lsd-maddrive/zaWRka-project/controller_wr_driver/README.md

# Драйвер для контроллера zaWRka

## Подготовка

- Set environment `CHIBIOS_ROOT` as path to ChibiOS version 17 directory.

Like this:

```bash
export CHIBIOS_ROOT=$HOME/ChibiStudio/chibios176
```

- Don`t forget to send ssh-key to zaWRka

Полезные ссылки:
* [F767ZI Reference manual (RM)](http://www.st.com/content/ccc/resource/technical/document/reference_manual/group0/96/8b/0d/ec/16/22/43/71/DM00224583/files/DM00224583.pdf/jcr:content/translations/en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)
* [F767ZI Datasheet (DS)](http://www.st.com/content/ccc/resource/technical/document/datasheet/group3/c5/37/9c/1d/a6/09/4e/1a/DM00273119/files/DM00273119.pdf/jcr:content/translations/en.DM0027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)
* [F767ZI Nucleo pinout](https://os.mbed.com/platforms/ST-Nucleo-F767ZI/)
---
* [F767ZI Alternate functions](http://www.st.com/content/ccc/resource/technical/document/datasheet/group3/c5/37/9c/1d/a6/09/4e/1a/DM00273119/files/DM00273119.pdf/jcr:content/translations/en.DM0027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)
* [F767ZI Pins assignment (+analogs)](http://www.st.com/content/ccc/resource/technical/document/datasheet/group3/c5/37/9c/1d/a6/09/4e/1a/DM00273119/files/DM00273119.pdf/jcr:content/translations/en.DM0027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)
* [F767ZI Timer triggers](http://www.st.com/content/ccc/resource/technical/document/reference_manual/group0/96/8b/0d/ec/16/22/43/71/DM00224583/files/DM00224583.pdf/jcr:content/translations/en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)
