lsd-maddrive/zaWRka-project/docs/presentations/Autonet2020.pptx

## Autonet 2020

Девяткин Алексей

## Задача этого года

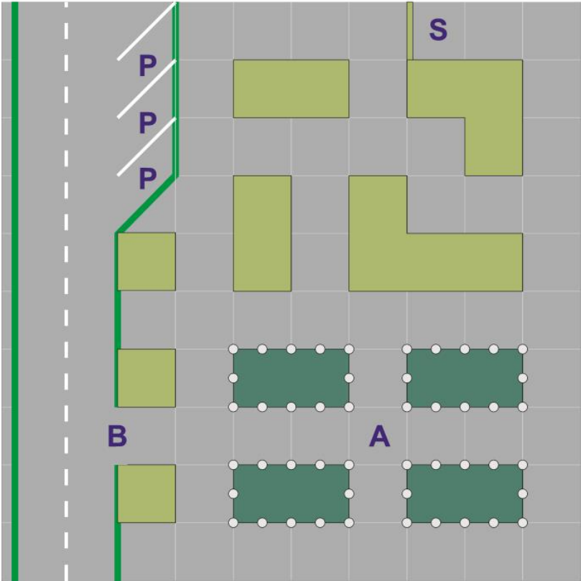
[picture p5: figure]

Ссылка: http://russianrobotics.ru/competition/autonet/autonet-18/
- Выехать из города
- Проехать по скоростному участку
- Припарковаться на свободном месте

## Этап 1 - Движение в городе

- Движение по знакам
- Остановка перед белой линией светофора (красный)
- Нет препятствий

## Этап 2 - Движение по скоростному участку

- Могут быть препятствия в виде грузовиков
- Препятствие не более 50 см по стороне

## Этап 3 - Парковка

- Припарковаться в одном из трех мест
- Место может быть занято

## Этап 1 - Решение

Базовая логика

Конечный автомат

Детектор знаков

Детектор белой линии

Решатель лабиринта

ROS планер

## Этап 1 - Решение

- Дождаться информации с контроллера о том, что кнопка нажата (ROS топик)
- Решить лабиринт с учетом расположения (решатель)
- Передать точки движения из решателя и задать цель (выезд из лабиринта) планеру
- Если встретилась линия и красный светофор - сбросить цель, дождаться зеленого, снова задать цель
- Если знак возле развилки - задать ограничения решателю на целевой узел, получить новые точки от решателя и передать планеру
- Если доехали -> второй этап

## Этап 1 - Решение (конечный автомат)

- IDLE - ждем кнопку
- MOVE_TARGET - движемся к цели (читаем линию знаки)
- WAIT_TL - ждем зеленого света (читаем знаки)
- WAIT_SIGNS (???) - без движения проверяем знаки (читаем знаки)
- TARGET_REACHED - достигли цели (следующий этап)
- MOVE_SPEED - движение по скоростному участку (ждем достижения цели)
- SPEED_REACHED - закончили скоростной участок
- ANALYZING_PARKING - анализ парковки
- MOVE_PARKING - паркуемся (ждем достижения цели)
- PARKING_REACHED - закончили парковку

## Этап 2 - Решение

- Просто проехать по планеру =)
- Обновляем конфигурацию планера -> выше скорость

## Этап 3 - Решение

- Разрабатывается решение по анализу заранее заданного места для парковки
- Обновляем конфигурацию планера -> ниже скорость

## Спасибо за внимание!
