lsd-maddrive/zaWRka-project/3D_models/jetson_case/Nvidia_Jetson_Nano_Case__NanoMesh_Desktop/images/6d35b3677f04a7914d906e52e0687398_preview_featured.JPG

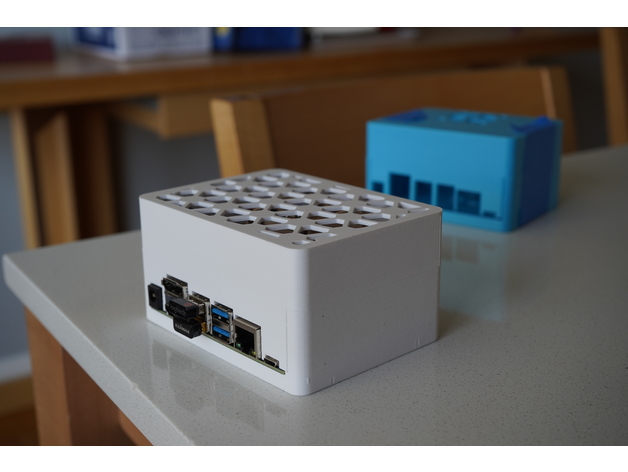
3D_models/jetson_case/Nvidia_Jetson_Nano_Case__NanoMesh_Desktop/images/6d35b3677f04a7914d906e52e0687398_preview_featured.JPG
