lsd-maddrive/zaWRka-project/3D_models/jetson_case/Nvidia_Jetson_Nano_Case__NanoMesh_Desktop/images/019526b72700fd8e877444ab914aaee8_preview_featured.JPG

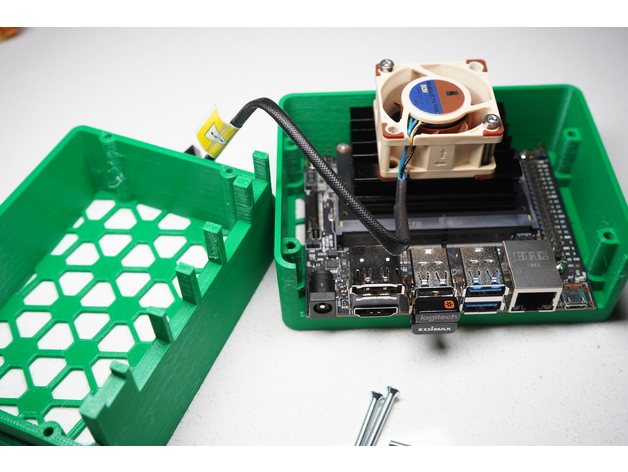
3D_models/jetson_case/Nvidia_Jetson_Nano_Case__NanoMesh_Desktop/images/019526b72700fd8e877444ab914aaee8_preview_featured.JPG
