lsd-maddrive/zaWRka-project/3D_models/jetson_case/Nvidia_Jetson_Nano_Case__NanoMesh_Desktop/images/a8ec58c3724dc3419c5b495eca3d6831_preview_featured.JPG

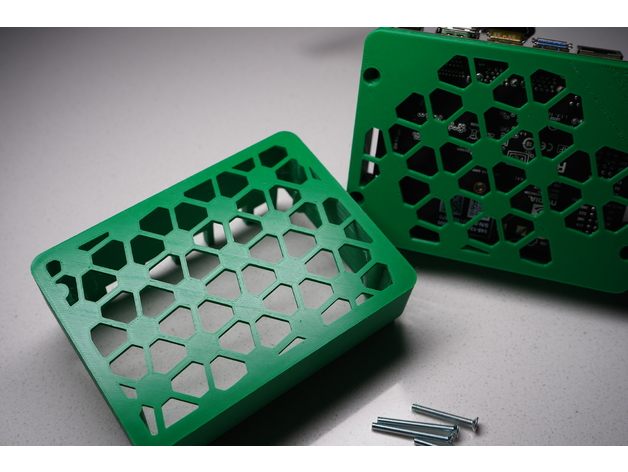
3D_models/jetson_case/Nvidia_Jetson_Nano_Case__NanoMesh_Desktop/images/a8ec58c3724dc3419c5b495eca3d6831_preview_featured.JPG
