lsd-maddrive/zaWRka-project/3D_models/jetson_case/Nvidia_Jetson_Nano_Case__NanoMesh_Desktop/images/aa94fbc3bea92b1af5b5fca5223404d8_preview_featured.jpg

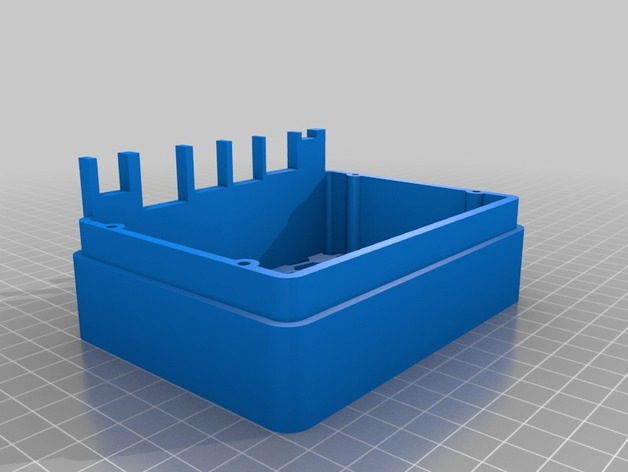
3D_models/jetson_case/Nvidia_Jetson_Nano_Case__NanoMesh_Desktop/images/aa94fbc3bea92b1af5b5fca5223404d8_preview_featured.jpg
