lsd-maddrive/zaWRka-project/3D_models/jetson_case/Nvidia_Jetson_Nano_Case__NanoMesh_Desktop/images/d14ae87a6a375f4f10650ded05f34fa1_preview_featured.jpg

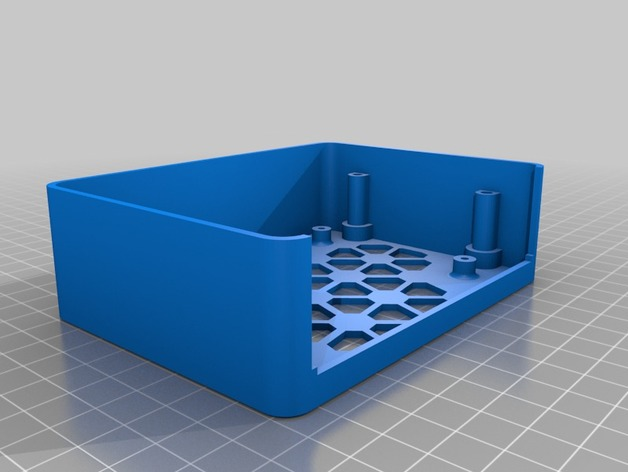
3D_models/jetson_case/Nvidia_Jetson_Nano_Case__NanoMesh_Desktop/images/d14ae87a6a375f4f10650ded05f34fa1_preview_featured.jpg
