lsd-maddrive/zaWRka-project/3D_models/jetson_case/Nvidia_Jetson_Nano_Case__NanoMesh_Desktop/images/f1ab23783ada1df2c52e6c94efddc131_preview_featured.JPG

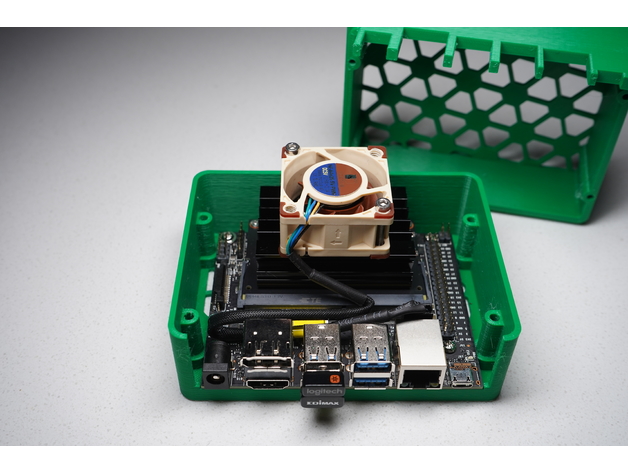
3D_models/jetson_case/Nvidia_Jetson_Nano_Case__NanoMesh_Desktop/images/f1ab23783ada1df2c52e6c94efddc131_preview_featured.JPG
