lsd-maddrive/zaWRka-project/3D_models/jetson_case/Nvidia_Jetson_Nano_Case__NanoMesh_Desktop/images/f44073ed6252e81bb559d2e7bacd4eea_preview_featured.JPG

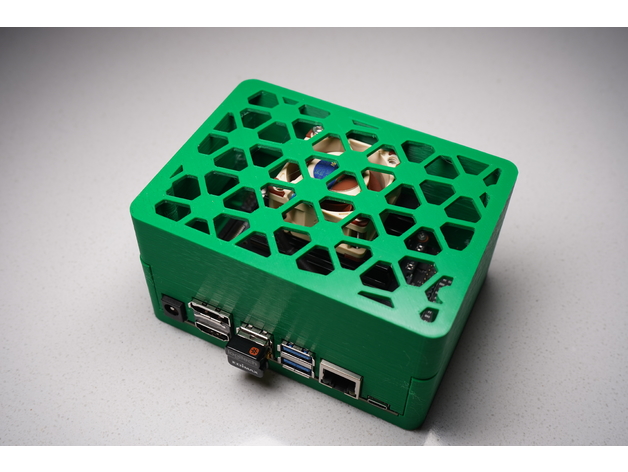
3D_models/jetson_case/Nvidia_Jetson_Nano_Case__NanoMesh_Desktop/images/f44073ed6252e81bb559d2e7bacd4eea_preview_featured.JPG
