lsd-maddrive/zaWRka-project/Altium_projects/zaWRka_Project/car1.bmp

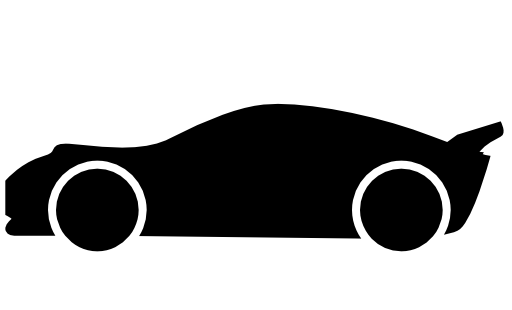
Altium_projects/zaWRka_Project/car1.bmp
