lsd-maddrive/zaWRka-project/docs/rendered/zaWRka-uC.png

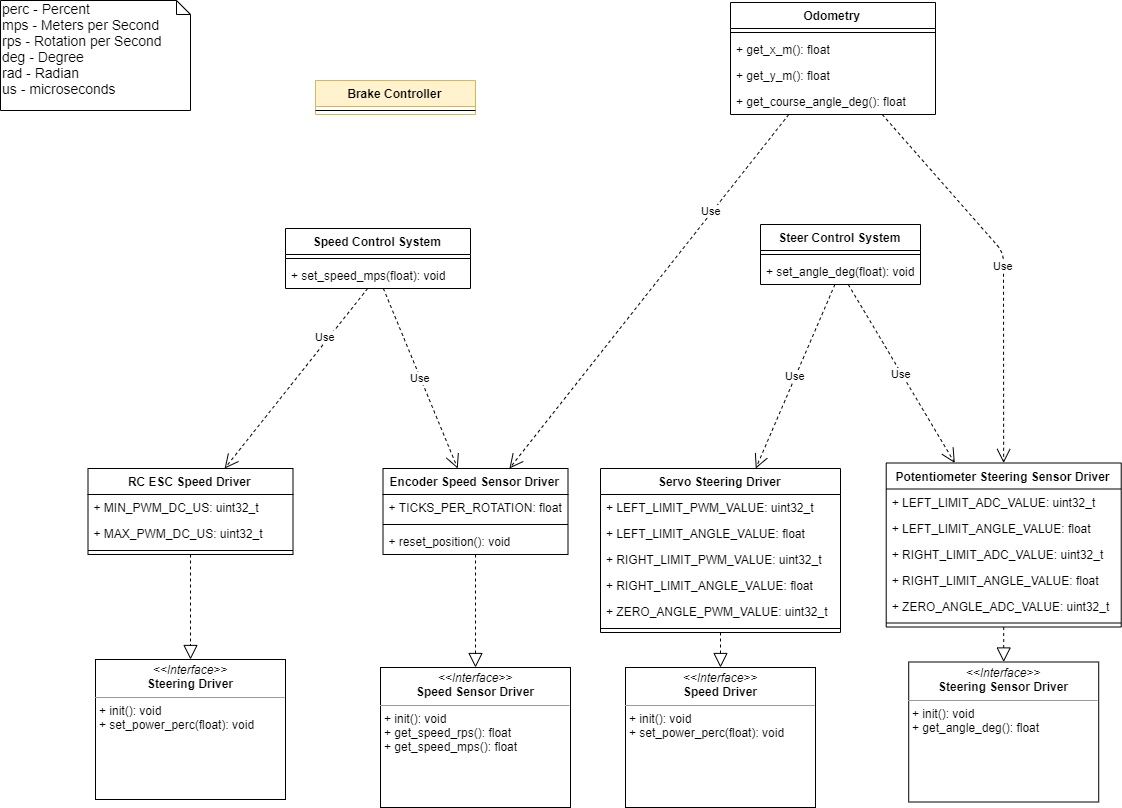
docs/rendered/zaWRka-uC.png
