lsd-maddrive/zaWRka-project/wr8_software/scripts/graph_path/signs.jpg

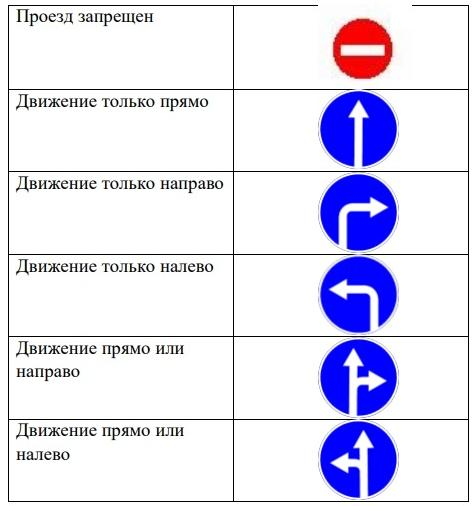
wr8_software/scripts/graph_path/signs.jpg
