lsd-maddrive/zaWRka-project/3D_models/2s_accum_holder/Battery_holder.FCStd

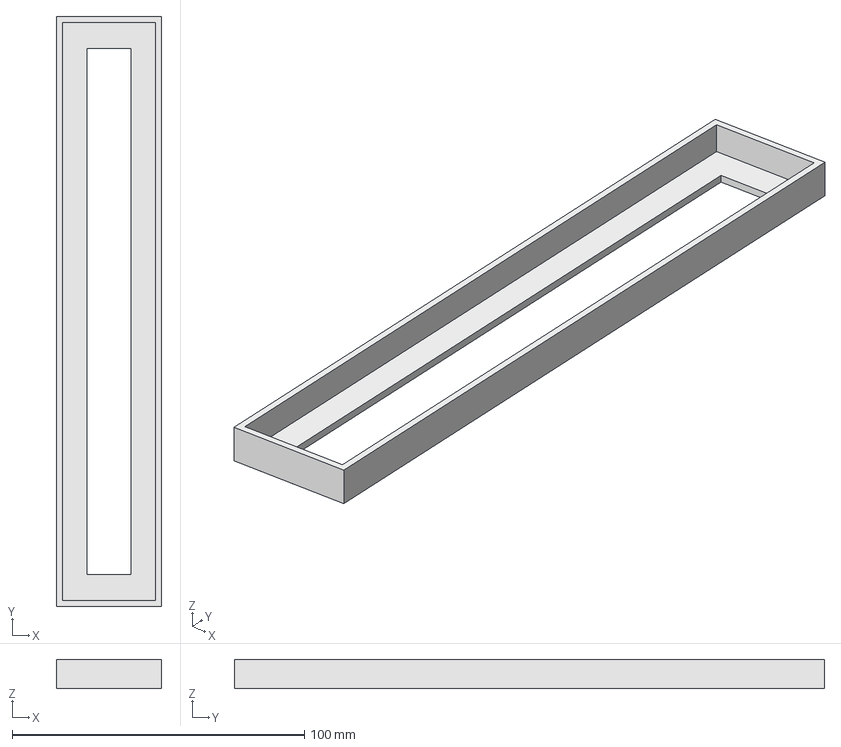
[picture p54: CAD file, 2020-01-11]
3D_models/2s_accum_holder/Battery_holder.FCStd
36.0 x 202.0 x 10.0 mm
