lsd-maddrive/zaWRka-project/3D_models/Battery_charge_check/Battery_up_1.stl

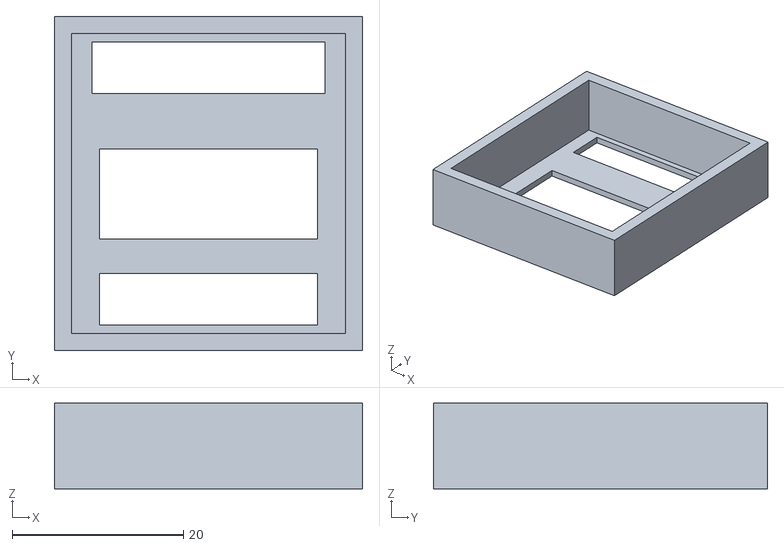
[picture p55: CAD file, 2020-01-11]
3D_models/Battery_charge_check/Battery_up_1.stl
36.0 x 39.0 x 10.0
