lsd-maddrive/zaWRka-project/3D_models/battery_holder/wr8_frame.stl

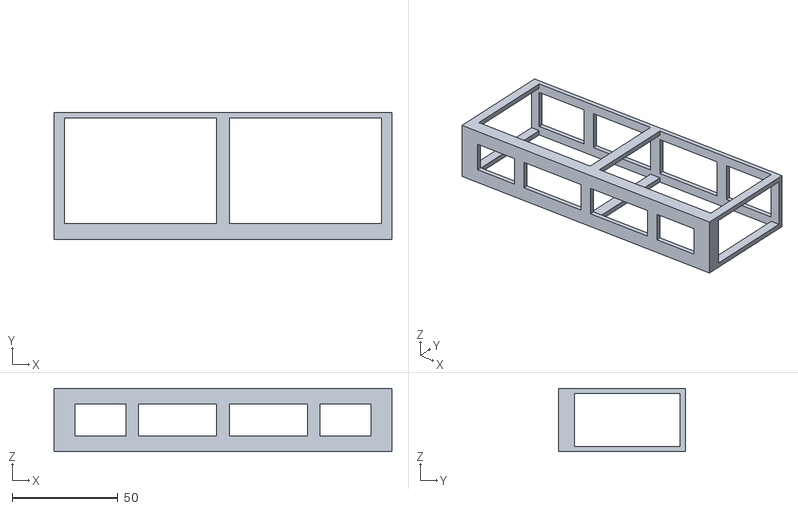
[picture p56: CAD file, 2020-03-07]
3D_models/battery_holder/wr8_frame.stl
160.0 x 60.0 x 30.0
