lsd-maddrive/zaWRka-project/3D_models/Encoder_new/Motor_hold.FCStd

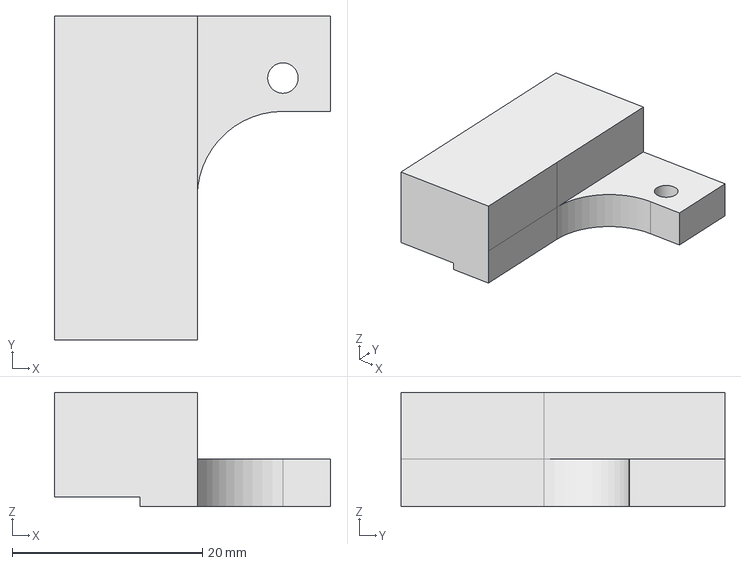
[picture p57: CAD file, 2020-01-11]
3D_models/Encoder_new/Motor_hold.FCStd
29.0 x 34.0 x 12.0 mm
