lsd-maddrive/zaWRka-project/3D_models/jetson_case/Nvidia_Jetson_Nano_Case__NanoMesh_Desktop/files/NanoMeshDesktop-Top-Jetson-Nano-DevKit-Case.stl

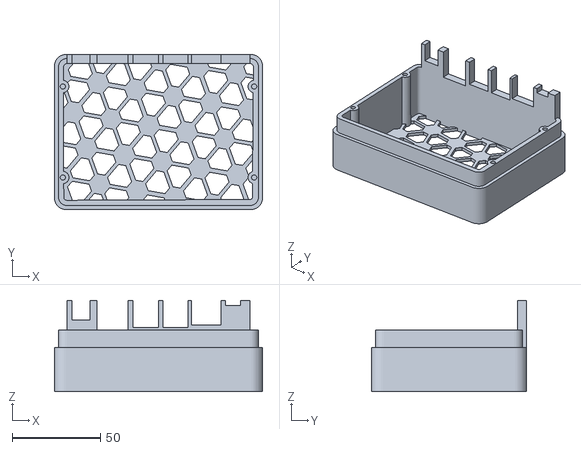
[picture p58: CAD file, 2020-01-11]
3D_models/jetson_case/Nvidia_Jetson_Nano_Case__NanoMesh_Desktop/files/NanoMeshDesktop-Top-Jetson-Nano-DevKit-Case.stl
118.0 x 88.0 x 51.8
