lsd-maddrive/zaWRka-project/3D_models/jetson_case/top.FCStd

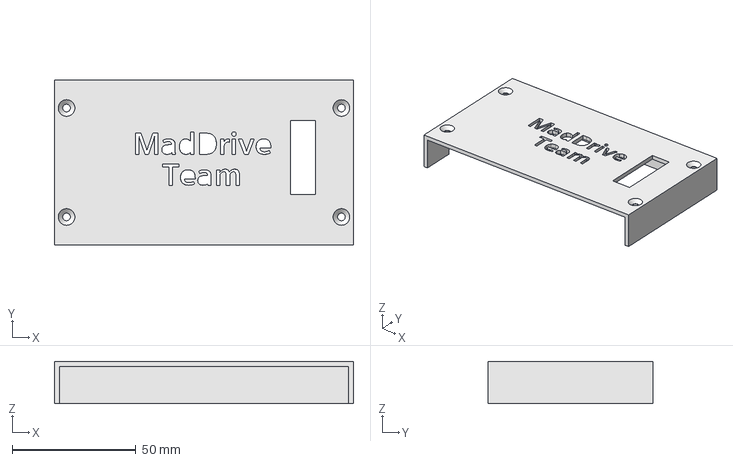
[picture p59: CAD file, 2020-01-11]
3D_models/jetson_case/top.FCStd
120.8 x 66.8 x 17.0 mm
