lsd-maddrive/zaWRka-project/3D_models/Lev_0_button_holder/Button_holder_2.stl

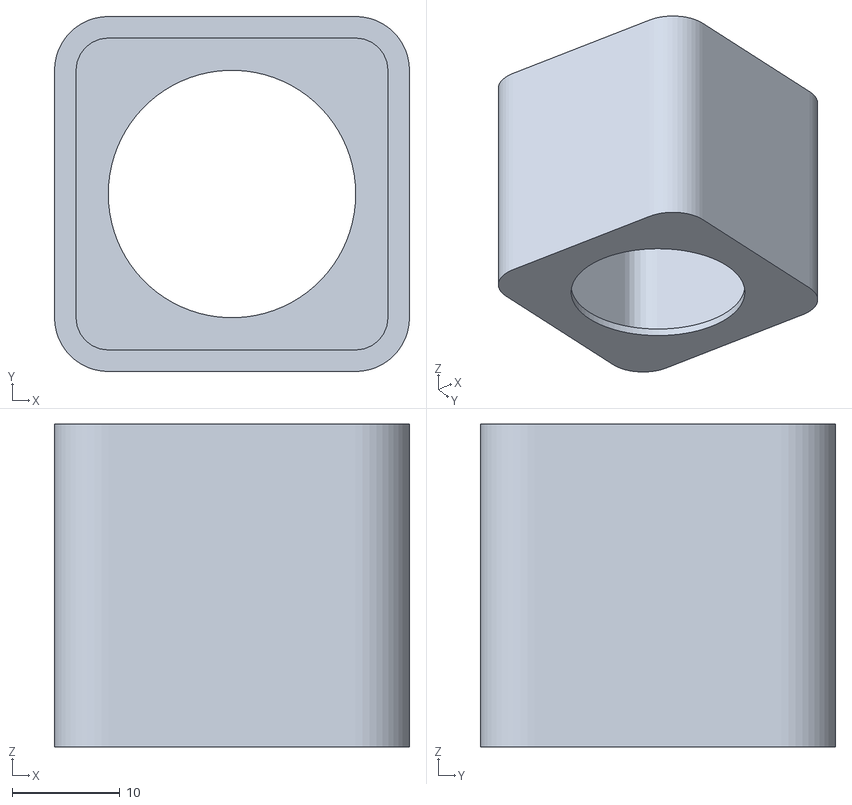
[picture p60: CAD file, 2020-01-11]
3D_models/Lev_0_button_holder/Button_holder_2.stl
33.0 x 33.0 x 30.0
