lsd-maddrive/zaWRka-project/3D_models/Lev_0_ESC_holder/ESC_holder_tight.FCStd

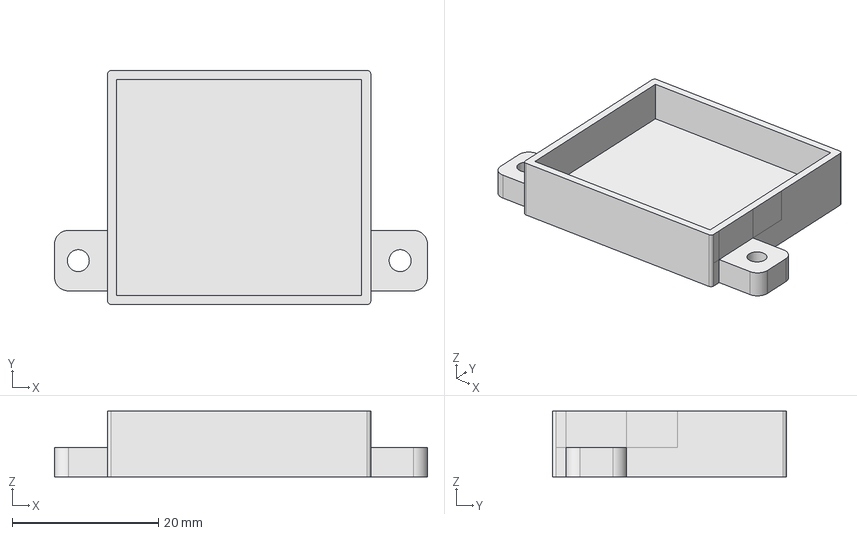
[picture p61: CAD file, 2020-01-11]
3D_models/Lev_0_ESC_holder/ESC_holder_tight.FCStd
51.0 x 32.0 x 9.00 mm
