lsd-maddrive/zaWRka-project/3D_models/Lidar_board/bottom.FCStd

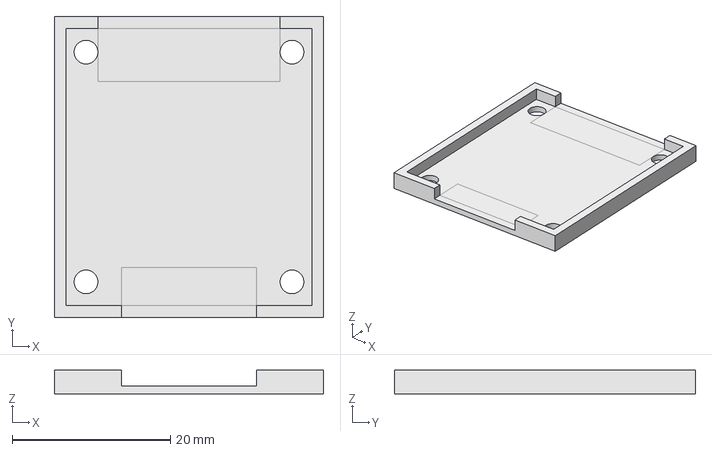
[picture p62: CAD file, 2020-01-11]
3D_models/Lidar_board/bottom.FCStd
34.0 x 38.0 x 3.00 mm
