lsd-maddrive/zaWRka-project/3D_models/name.FCStd

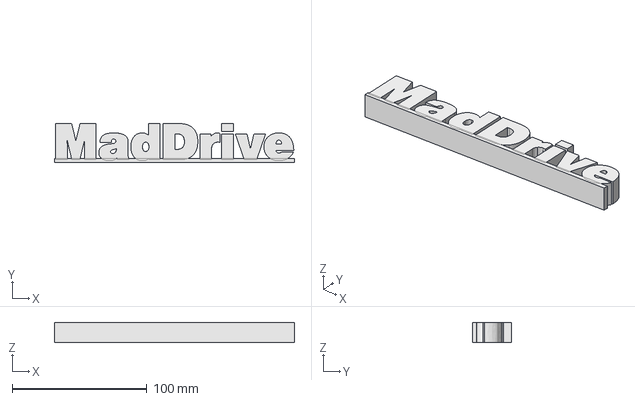
[picture p63: CAD file, 2020-01-11]
3D_models/name.FCStd
178.0 x 28.8 x 15.0 mm
