lsd-maddrive/zaWRka-project/3D_models/power_conv/box/box_power.FCStd

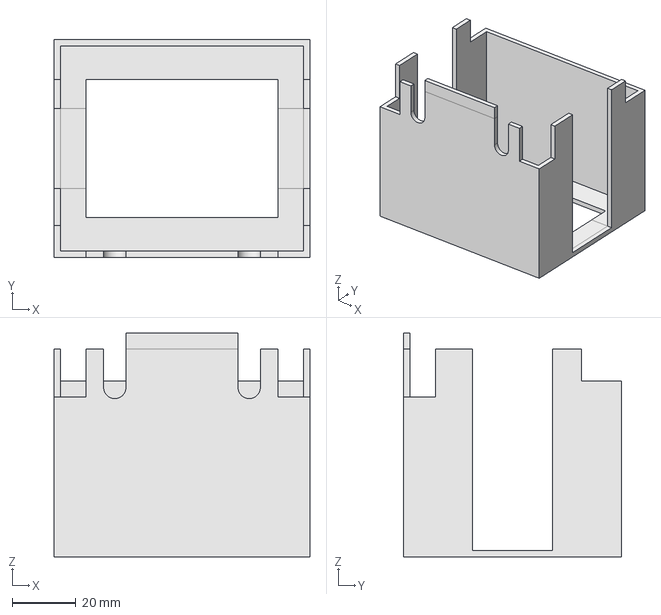
[picture p64: CAD file, 2020-03-07]
3D_models/power_conv/box/box_power.FCStd
80.0 x 68.0 x 70.0 mm
