lsd-maddrive/zaWRka-project/3D_models/power_conv/tree_lev_0.stl

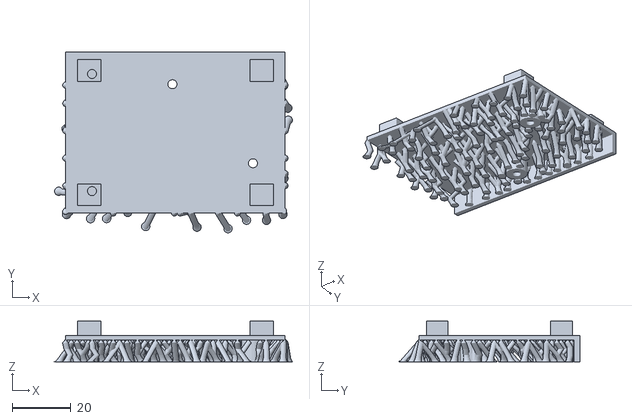
[picture p65: CAD file, 2020-01-11]
3D_models/power_conv/tree_lev_0.stl
81.3 x 61.8 x 14.0
