lsd-maddrive/zaWRka-project/3D_models/Power_new/power_wire.FCStd

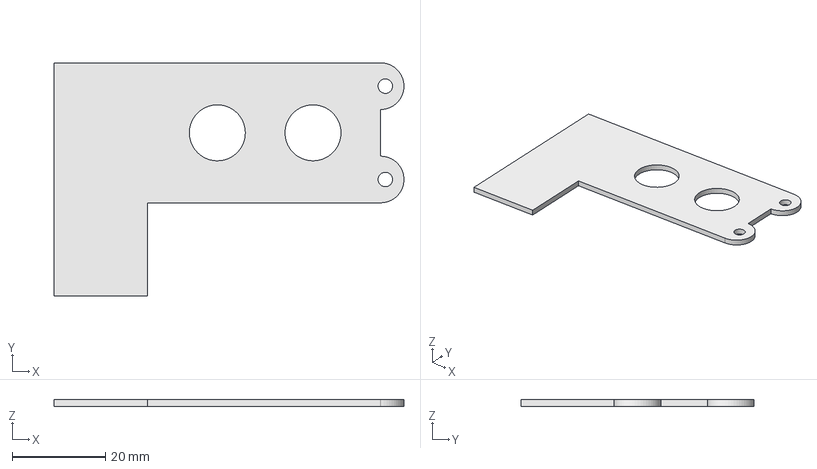
[picture p66: CAD file, 2020-01-11]
3D_models/Power_new/power_wire.FCStd
75.0 x 50.0 x 1.50 mm
