lsd-maddrive/zaWRka-project/3D_models/servo_kach/servo1.stl

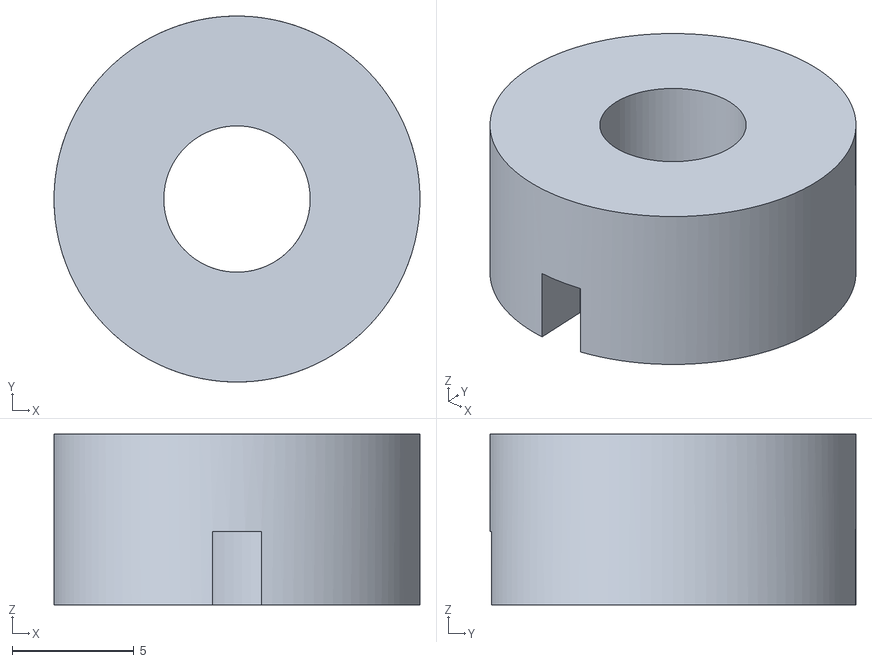
[picture p67: CAD file, 2020-01-11]
3D_models/servo_kach/servo1.stl
15.0 x 15.0 x 7.00
