lsd-maddrive/zaWRka-project/3D_models/Spring_support/Spring_support.FCStd

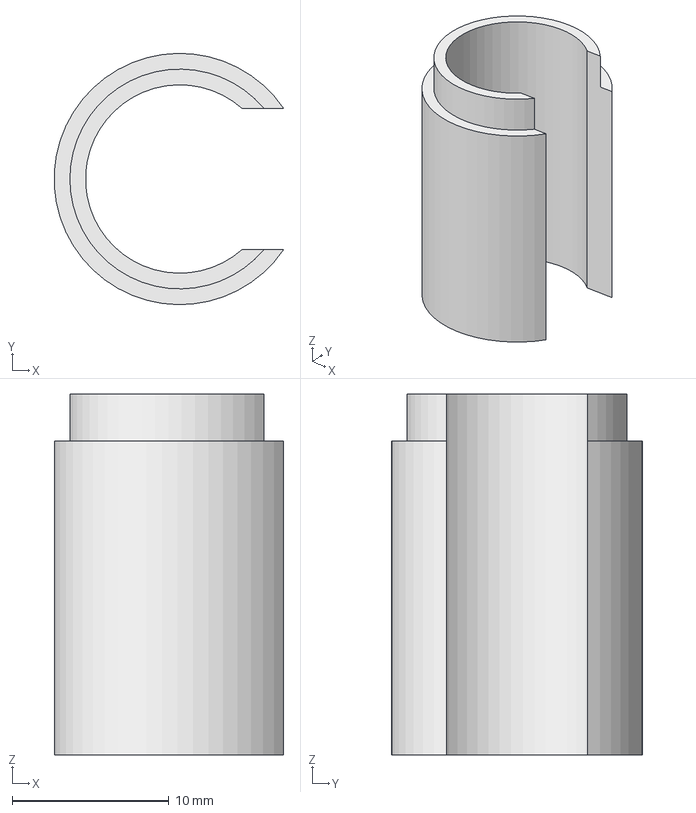
[picture p68: CAD file, 2020-01-11]
3D_models/Spring_support/Spring_support.FCStd
14.6 x 16.0 x 23.0 mm
