lsd-maddrive/zaWRka-project/3D_models/STM_hold_corner/STM_holder_rev.FCStd

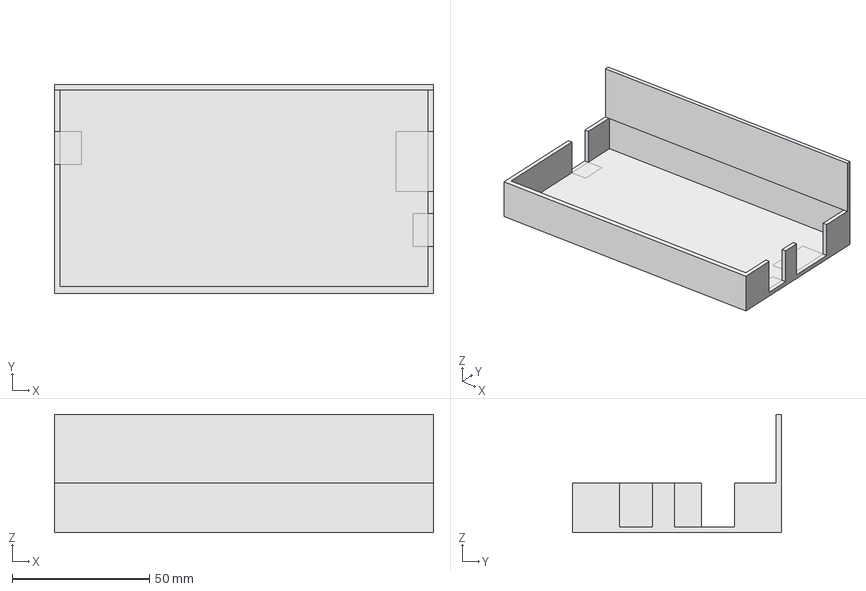
[picture p69: CAD file, 2020-03-07]
3D_models/STM_hold_corner/STM_holder_rev.FCStd
138.0 x 76.0 x 43.0 mm
