lsd-maddrive/zaWRka-project/3D_models/Transmitter_holder/Transmitter_holder.FCStd

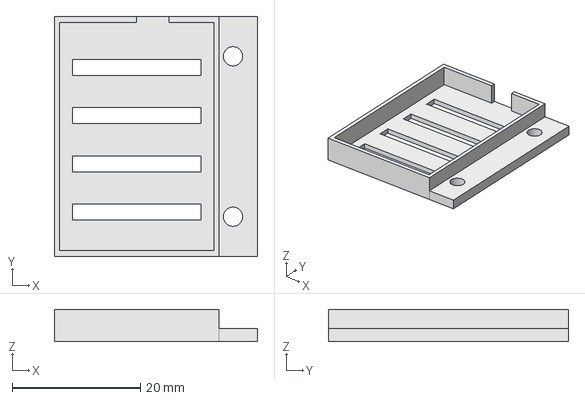
[picture p70: CAD file, 2020-01-11]
3D_models/Transmitter_holder/Transmitter_holder.FCStd
31.7 x 37.4 x 5.00 mm
