lsd-maddrive/zaWRka-project/3D_models/Turn/tirn_v1.FCStd

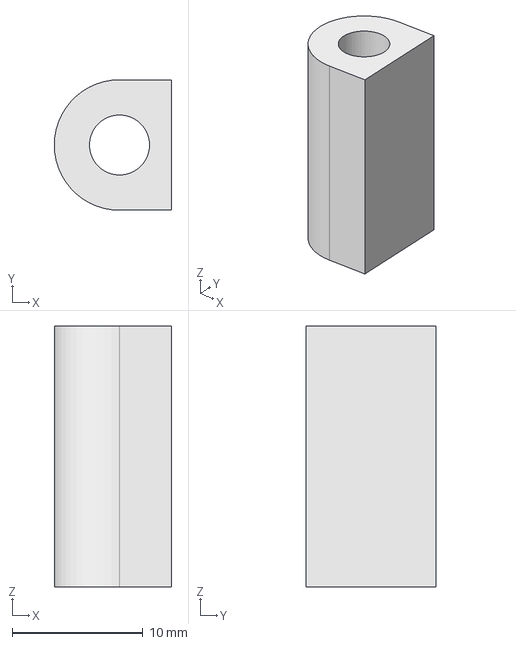
[picture p71: CAD file, 2020-01-11]
3D_models/Turn/tirn_v1.FCStd
9.00 x 10.0 x 20.0 mm
