lsd-maddrive/zaWRka-project/3D_models/jetson_case/bottom.FCStd

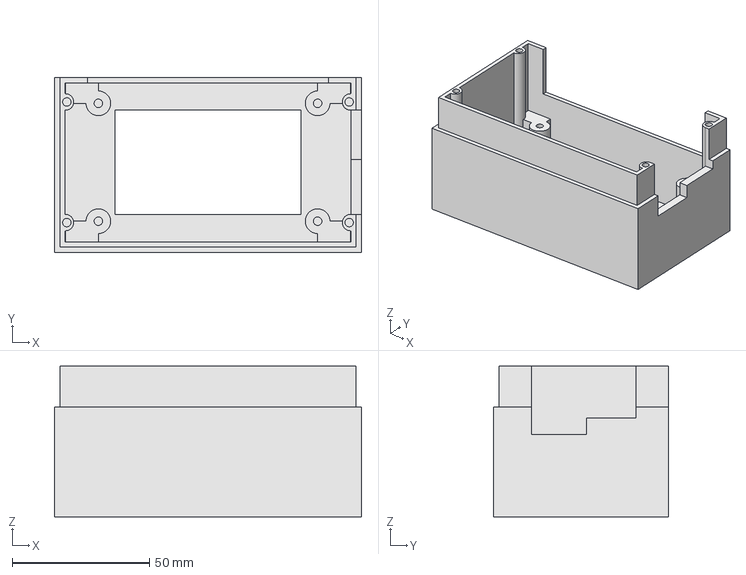
[picture p72: CAD file, 2020-01-11]
3D_models/jetson_case/bottom.FCStd
112.0 x 64.0 x 55.0 mm
