lsd-maddrive/zaWRka-project/3D_models/Lidar_board/top.FCStd

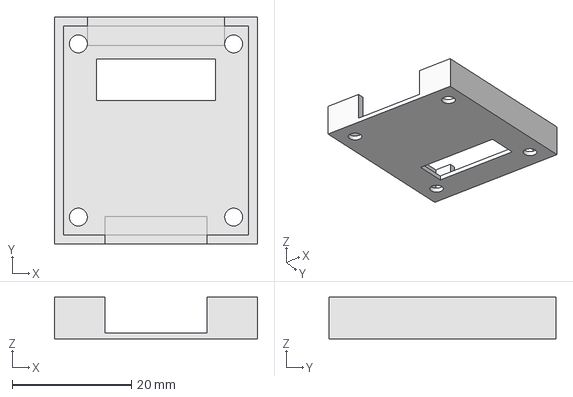
[picture p74: CAD file, 2020-01-11]
3D_models/Lidar_board/top.FCStd
34.0 x 38.0 x 7.00 mm
