lsd-maddrive/zaWRka-project/3D_models/power_conv/tree_lev_1.stl

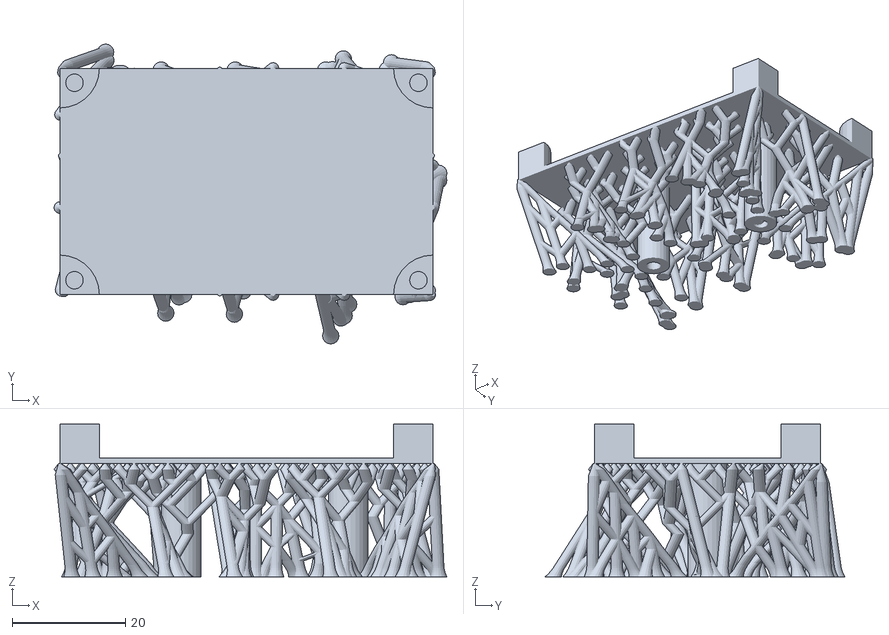
[picture p75: CAD file, 2020-01-11]
3D_models/power_conv/tree_lev_1.stl
69.5 x 53.0 x 27.0
