lsd-maddrive/zaWRka-project/3D_models/Power_new/Power_hold.FCStd

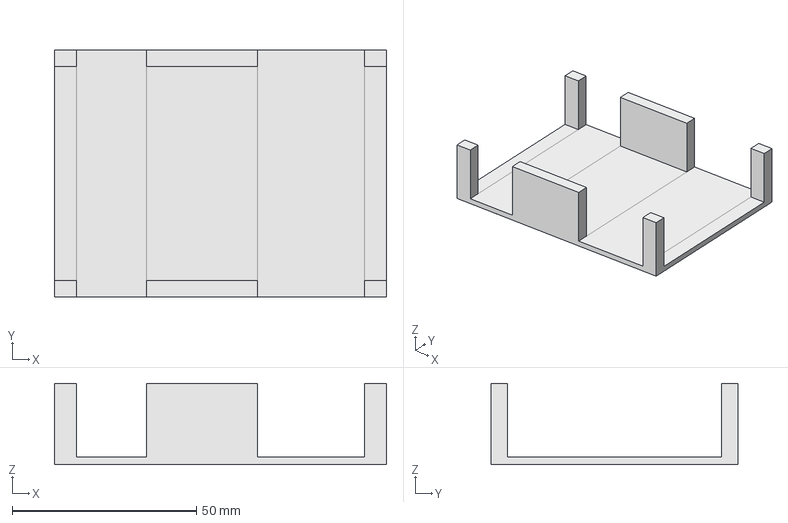
[picture p76: CAD file, 2020-01-11]
3D_models/Power_new/Power_hold.FCStd
90.0 x 67.0 x 22.0 mm
