lsd-maddrive/zaWRka-project/3D_models/servo_kach/servo_kulak.FCStd

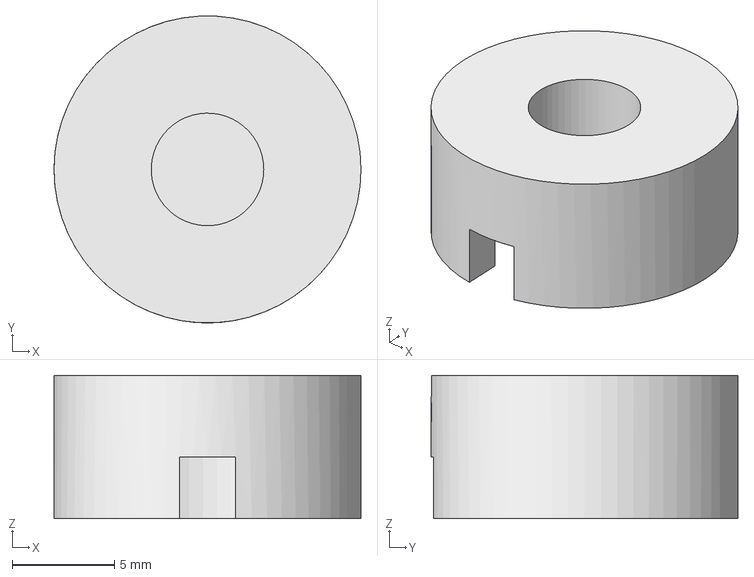
[picture p77: CAD file, 2020-01-11]
3D_models/servo_kach/servo_kulak.FCStd
15.0 x 15.0 x 7.00 mm
