lsd-maddrive/zaWRka-project/3D_models/STM_hold_corner/STM_holder.FCStd

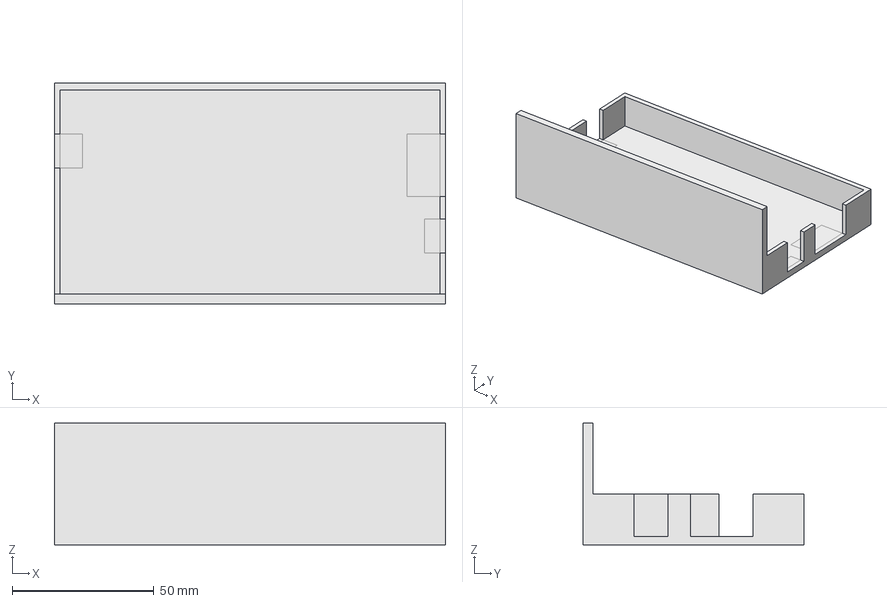
[picture p78: CAD file, 2020-01-11]
3D_models/STM_hold_corner/STM_holder.FCStd
138.0 x 78.0 x 43.0 mm
