lsd-maddrive/zaWRka-project/3D_models/power_conv/level1.FCStd

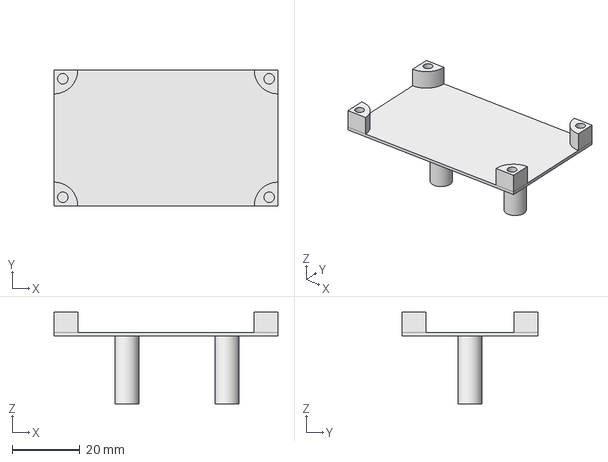
[picture p79: CAD file, 2020-01-11]
3D_models/power_conv/level1.FCStd
66.0 x 40.0 x 27.0 mm
