lsd-maddrive/zaWRka-project/3D_models/power_conv/level2.FCStd

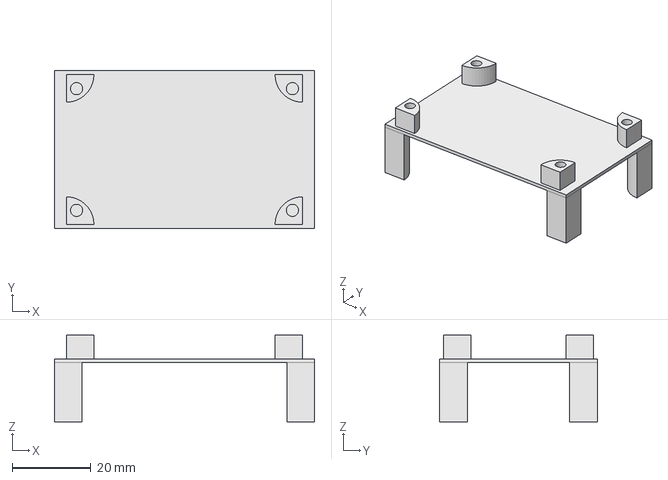
[picture p80: CAD file, 2020-01-11]
3D_models/power_conv/level2.FCStd
66.0 x 40.0 x 22.0 mm
