lsd-maddrive/zaWRka-project/3D_models/STM_hold_corner/stm_corner.FCStd

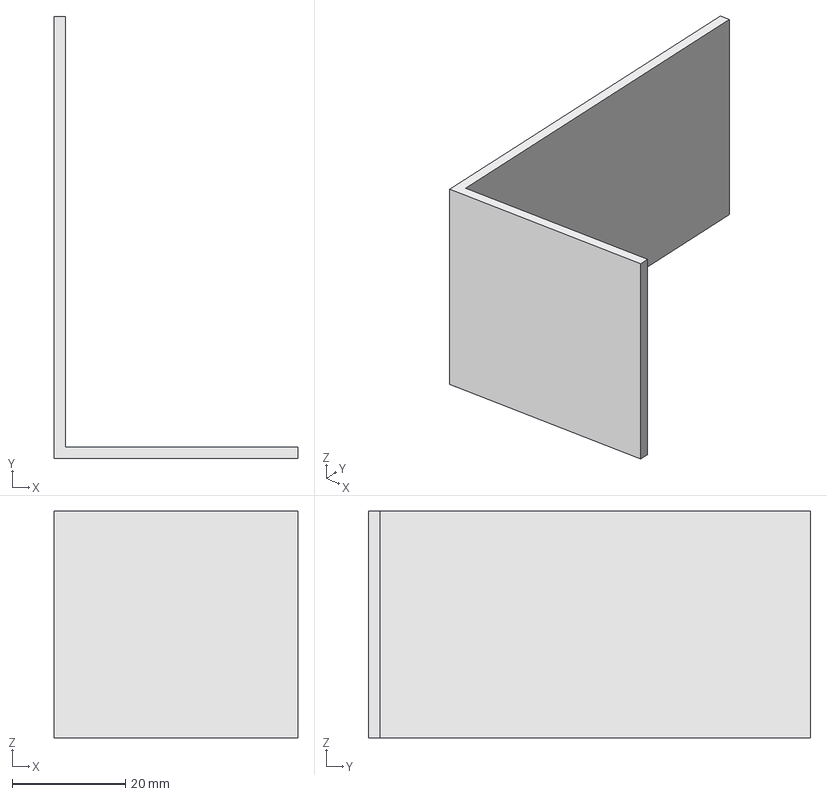
[picture p81: CAD file, 2020-01-11]
3D_models/STM_hold_corner/stm_corner.FCStd
43.0 x 78.0 x 40.0 mm
