lsd-maddrive/zaWRka-project/3D_models/power_conv/tree_lev_2.stl

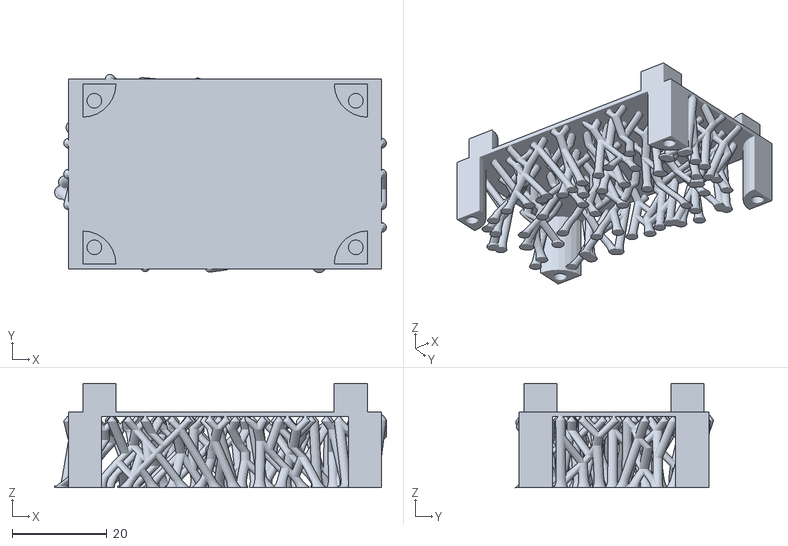
[picture p82: CAD file, 2020-01-11]
3D_models/power_conv/tree_lev_2.stl
70.0 x 41.8 x 22.0
