lsd-maddrive/zaWRka-project/3D_models/power_conv/level0.FCStd

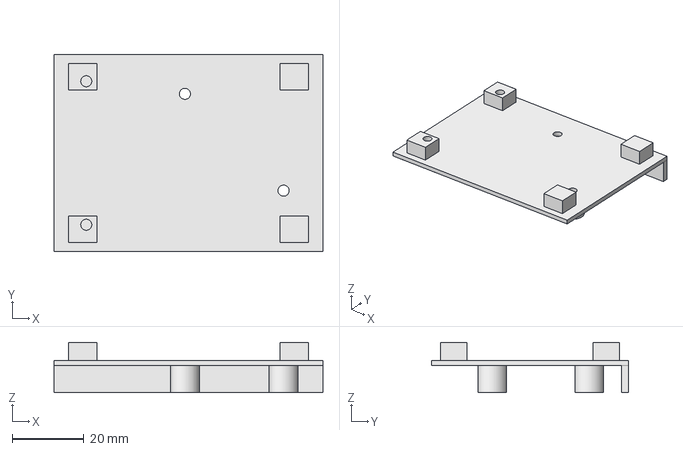
[picture p83: CAD file, 2020-01-11]
3D_models/power_conv/level0.FCStd
75.0 x 55.0 x 14.0 mm
