lsd-maddrive/zaWRka-project/(list of files, cad)

Other CAD files:
3D_models/Battery_charge_check/battery_top.FCStd
3D_models/battery_holder/frame.FCStd
3D_models/Lev_0_button_holder/Button_holder_v2.FCStd
3D_models/Turn/turn.stl
3D_models/Power_new/Power_wr8_hold.stl
3D_models/STM_hold_corner/STM_hold.stl
3D_models/2s_accum_holder/Battery_holder.stl
3D_models/Encoder_new/Motor_hold.stl
3D_models/Lev_0_ESC_holder/ESC_holder_tight.stl
3D_models/Lidar_board/bottom.stl
3D_models/Lidar_board/top.stl
3D_models/Power_new/power_wire.stl
3D_models/STM_hold_corner/STM_holder_rev.stl
3D_models/STM_hold_corner/stm_corner.stl
3D_models/Spring_support/spring_support.stl
3D_models/Transmitter_holder/Transmitter_holder.stl
3D_models/jetson_case/bottom.stl
3D_models/jetson_case/top.stl
3D_models/name.stl
3D_models/power_conv/box/box_power.stl
3D_models/power_conv/level_0.stl
3D_models/power_conv/level_1.stl
3D_models/power_conv/level_2.stl
3D_models/servo_kach/servo_kulak.stl
