lsd-maddrive/zaWRka-project/wr8_software/scripts/line_detector_test_1.png

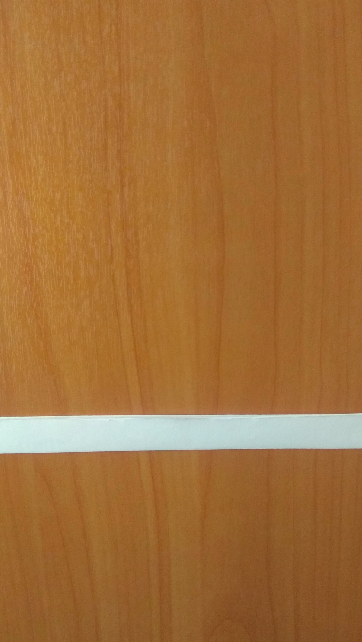
wr8_software/scripts/line_detector_test_1.png
