lsd-maddrive/zaWRka-project/wr8_software/scripts/line_detector_test_2.png

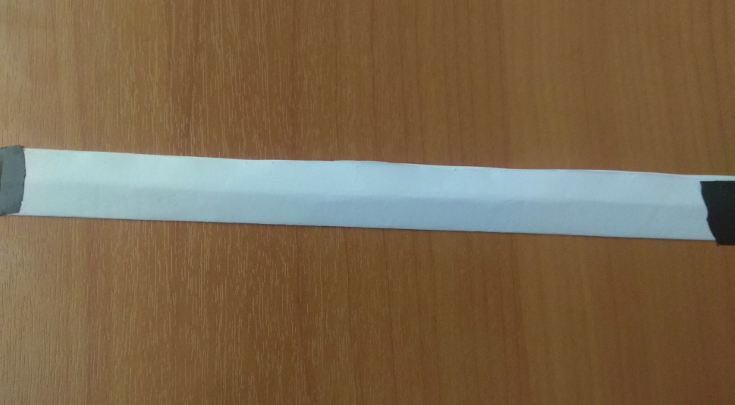
wr8_software/scripts/line_detector_test_2.png
