lsd-maddrive/zaWRka-project/wr8_software/scripts/debug/lane_debug.png

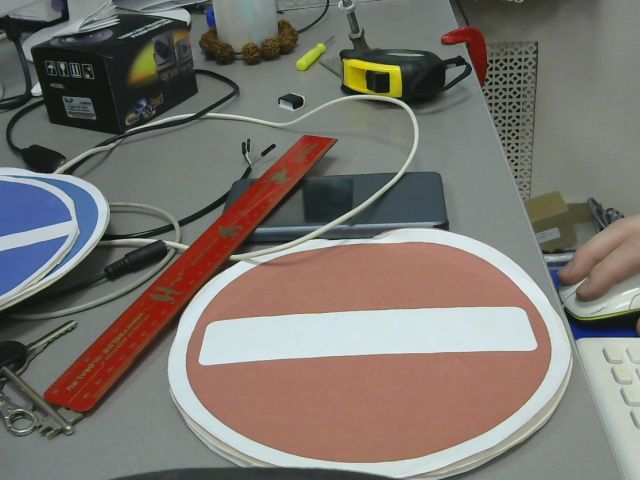
wr8_software/scripts/debug/lane_debug.png
