lsd-maddrive/zaWRka-project/(threads)

Thread 1 (2019-02-11):

Что нужно в ветке master хранить?

serykhelena, 2019-02-11:

KaiL4eK, 2019-02-12:
Пускай мастер будет основной веткой, просто льем туда, когда фича / модуль готовы

KaiL4eK, 2019-02-12:
Либо можно master удалить, а develop сделать основной)

KaiL4eK, 2019-02-12:
Так как вся работа пошла в develop, то предлагаю мастера сносить =)

serykhelena, 2019-02-12:
Сделано (=

Closed 2019-02-12.

Thread 2 (2019-02-12):

Проблема в понимании блока одометрии

serykhelena, 2019-02-12:
В ветке encoder добавила файлы для работы с энкодером и одометрией.
В энкодере работает таймер с периодом 1 секунда, получается скорость.
Дальше скорость в м/с (взято как пример) передаётся в аргументы функций одометром, где происходит типа интегрирование теты, х и у.
Результаты странные.

Есть мысль, что есть косяки в понимании математики процесса.

serykhelena, 2019-02-13:
@KaiL4eK , подправила модуль одометрии, можешь провести ревизию по возможности. Для тестов жду, когда освободится STM-ка

KaiL4eK, 2019-02-14:
Воу, так ты объединила энкодер и одометрию?

serykhelena, 2019-02-15:
@KaiL4eK, я может быть неправильно поняла, но в предыдущем сообщении договорились, что я использую один таймер для всего, поэтому я объединила. Но не могу сказать, что это удобно. Слишком много всего в одном файле.

KaiL4eK, 2019-02-15:
Здесь можно сделать так, чтобы таймер был только в одометрии, а энкодер рассчитывал значние скорости только по запросу (вызову функции get). Или просто расчет переложить на блок одометрии, а от энкодера требуется лишь отдавать нынешнее пройденное расстояние

KaiL4eK, 2019-02-15:
Для расчета скорости в одометрии можно брать предыдущий пройденный путь и нынешний

serykhelena, 2019-02-20:
Пока промежуточное понимание получено, в будущем если что открою новую issue ^_______^

Closed 2019-02-20.

Thread 3 (2019-02-12):

[ROS] Сброс данных позиционирования

KaiL4eK, 2019-02-12:
Для перезапуска и корректной работы нужно обнулять состояние робота. Если на контроллер еще можно передать команду, чтобы обнулить все внутренние представления и выдавать свежую одометрию от нуля, то для TF в ROS это более болезненное занятие. Пока есть мысль создать публикатор в TF для обновления последнего значения..

KaiL4eK, 2019-03-11:
В ROS контексте есть место под callback сброса одометрии - надо только подключить)

Closed 2019-03-11.

Thread 4 (2019-02-19):

[Объявление] Система переведена на режим tickless

KaiL4eK, 2019-02-19:
В chconf.h мы перешли на режим tickless, частота RT стала 100кГц, таймер, используемый для RT 32битный, 5й, это требование режима tickless.
Тебе стоит ожидать, что функция получения системного времени будет выдавать большие значения)
Просто оповещение, как прочитаешь, закрывай =)

serykhelena, 2019-02-20:
Прочитано, вроде даже понято (=

Closed 2019-02-20.

Thread 11 (2019-03-04):

Модуль индикации

serykhelena, 2019-03-04:
2х линейки светодиодов для аккумов
Матрица для индикации знаков
Светодиоды для индикации режимов

serykhelena, 2019-08-16:
Добавить в проект реализацию светодиодной матрицы, протестить в проекте
https://github.com/serykhelena/sand_box/tree/master/STM767_ChibiOS/spi_led

Thread 12 (2019-03-04):

Структура для параметров ПИД-регуляторов

serykhelena, 2019-03-04:
Реализована структура для модуля `drive_cs.c`, нужно разобраться как её правильно объявить, чтобы Егор мог до неё добраться

KaiL4eK, 2019-03-10:
В данном случае не Егор будет добираться до нее, а из ROS будет приходить инфа об установке нового набора параметров. Думаю, можно сделать функцию, аргумент которой является структурой с набором параметров, а модуль ROS будет ею пользовать при приходе новой инфы

serykhelena, 2019-03-11:
Пока что закрываю, пользовать функции можно будет после настройки СУ по скорости

Closed 2019-03-11.

Thread 13 (2019-03-09):

[state] Добавить систему состояний

KaiL4eK, 2019-03-09:
Пока в данной системе проглядывается два состояния - IDLE, RUN
IDLE - ожидание, двигатели не работают
RUN - все системы в рабочем режиме

Данную систему можно соединить с системой диодной индикации.
В каждой итерации рабочего цикла система должна отправлять на ROS нынешнее состояние

KaiL4eK, 2019-03-10:
В режиме IDLE разрешено управление с пульта RC

KaiL4eK, 2019-03-10:
При переходе в режим RUN происходит сброс одометрии (энкодера)

serykhelena, 2019-03-11:
Можешь пояснить, пожалуйста, в каком виде представить эти состояния? И где они должны быть? Что-то я не уверена

Thread 14 (2019-03-09):

[base] Добавить обработку таймаута по приходящему заданию

KaiL4eK, 2019-03-09:
Нужно в обработку команд от ROS добавить систему таймаута, чтобы обработать отстутствие приходящих команд. Время таймаута предлагаю 500мс.

serykhelena, 2019-03-11:
Правильно я понимаю, что ты о том, что можно запустить VT, и ты росом будешь вызывать функцию, которая будет перезапускать таймер, если таймер дойдёт до своего родного callback, то выставляется как-нибудь флаг и считаем, что рос откинулся? (=

Thread 18 (2019-09-23):

Не работает launch файл gz_localization_view

PonomarevDA, 2019-09-23:
Тестирую launch файл `gz_localization_view` из пакета wr8_software.
Скрипт запускается, все узлы тоже, начало работы не предвещает беды.
Но в какой-то момент все ломается: иногда раньше, иногда позже.
По ссылке видео с логами терминала от начала до конца. Проблема возникает в середине видео.
https://youtu.be/t0RAa0YhLrE
Привожу часть логов, которые видны на видео:
```
[ WARN] [1569236226.354755274, 193.566000000]: Costmap2DROS transform timeout. Current time: 193.5660, global_pose stamp: 191.5500, tolerance: 2.0000
[ WARN] [1569236226.354871985, 193.566000000]: Could not get robot pose, cancelling reconfiguration
[ WARN] [1569236226.573027750, 193.696000000]: Transform timeout for global_costmap. Current time: 193.6960, pose stamp: 191.6860, tolerance: 2.0000
[ WARN] [1569236226.901645078, 193.903000000]: Unable to get starting pose of robot, unable to create global plan
...
[ WARN] [1569236274.706857127, 223.701000000]: TebLocalPlannerROS: trajectory is not feasible. Resetting planner...
...
[ERROR] [1569236288.296048840, 234.292000000]: Failed to get a plan.
[ERROR] [1569236288.528671402, 234.491000000]: Aborting because a valid plan could not be found. Even after executing all recovery behaviors
```

В чем причина ошибок локализации пока не понимаю, почитаю про cost map подробнее.

PonomarevDA, 2019-09-23:
Замечу, что gz_slam_view.launch в принципе работает.

PonomarevDA, 2019-09-24:
Почитал ros форумы на счет этой проблемы.
1. [Costmap2DROS transform timeout](https://answers.ros.org/question/215256/costmap2dros-transform-timeout/)
2. [Costmap2DROS transform timeout.Could not get robot pose, cancelling reconfiguration](https://answers.ros.org/question/227638/costmap2dros-transform-timeoutcould-not-get-robot-pose-cancelling-reconfiguration/)

Решения я там никакого не нашел, но люди пишут, что процессор не успевает выполнять вычисления. По факту, как видно из `tf_monitor` или `view_frames`, с момента указания цели роботу, данные действительно начинают устаревать. Когда данные устаревают больше, чем значение tolerance, появляются warnings, а затем работа планера накрывается.

Отличие localization от slam лишь в том, что вместо `mapping_algorithm` появился `amcl`. Это наталкивает на мысль о том, что, в предположении, что процессор действительно не справляется, именно узлы скрипта `amcl.launch` максимально нагружают процессор. К слову, такие же выводы следуют из анализа графа, полученного из `view_frames`.

Короче, покрутив параметры `amcl.launch`, заметил, что `max_particles` оказывает прямое влияние на требуемую вычислительную способность процессора.
Одновременно запускал `view_frames` и указывал цель роботу при разных `max_particles`:
`max_particles` = 1000, delay = 0, [frames500_1000.pdf](https://github.com/lsd-maddrive/zaWRka-project/files/3648924/frames500_1000.pdf) (локализация работает хорошо)
`max_particles` = 2000, delay = 0, [frames500_2000.pdf](https://github.com/lsd-maddrive/zaWRka-project/files/3648926/frames500_2000.pdf) (с первого взгляда работает, но если покатать подольше, то тоже накрывается)
`max_particles` = 3000, delay = 2.45, [frames500_3000.pdf](https://github.com/lsd-maddrive/zaWRka-project/files/3648930/frames500_3000.pdf) (работа планера накрывается)
`max_particles` = 5000, delay = 4.3 сек, [frames500_5000.pdf](https://github.com/lsd-maddrive/zaWRka-project/files/3648931/frames500_5000.pdf) (работа планера накрывается очень быстро)

В итоге, сейчас при `max_particles` = 1000 все работает, багов при локализации пока не нашел.

KaiL4eK, 2019-09-25:
Так значит закрываем issue?)

Closed 2019-09-25.

Thread 33 (2020-01-25):

[uC] Вычистить код системы управления поворотом

KaiL4eK, 2020-01-25:
На данный момент система управления поворотом самодостаточна и опирается на серву - откалиброванные значения преобразования |АЦП (потенциометра) -> Угол -> ШИМ задания для сервы| позволяют управлять без контура обратной связи в СУ поворотом.
Требуется почистить код и заложиться на функции range_map_*()

Thread 41 (2020-03-14):

Проверить код line_detector после слияния PRов

KaiL4eK, 2020-03-14:
#38 #39 имеют общий код, который может перетереться, надо убедиться, что после слияния ничего не попортилось

PonomarevDA, 2020-03-14:
Ветка line_detector слита в main_solver.
Никаких изменений main_solver в файлах детектора линии не делает.
Поэтому там должен быть fast-forward merge.

Closed 2020-03-15.

Thread 47 (2020-03-15):

Research google cartographer

KaiL4eK, 2020-03-15:
https://google-cartographer.readthedocs.io/en/latest/

Nikolaj37, 2020-03-16:
Основное отличие Google cartographer-а от hector slam-а - это наличие сильной библиотека для проектов с 3D маппированием по стереокамере, как основного источника данных. В 2D режиме нужно проверять на симуляции для моделей. Я могу попробовать протестировать обе системы в симуляции на одной карте и будет виднее.

Nikolaj37, 2020-03-16:
После установки Google cartographer перестал работать xacro:

RLException: while processing /home/nikolay/catkin_ws/src/zaWRka-project/wr8_description/launch/gazebo.launch:
Invalid <param> tag: Cannot load command parameter [robot_description]: no such command [/home/nikolay/catkin_ws/src/xacro/xacro '/home/nikolay/catkin_ws/src/zaWRka-project/wr8_description/urdf/model.urdf.xacro' enable_stereo:=false].

Param xml is <param command="$(find xacro)/xacro '$(arg urdf_file)' enable_stereo:=$(arg enable_stereo)" name="robot_description"/>
The traceback for the exception was written to the log file

Nikolaj37, 2020-03-17:
Пробую установить google_cartographer, но возник следующий баг.
```
Could not find a package configuration file provided by
  "message_generation" with any of the following names:
    message_generationConfig.cmake
    message_generation-config.cmake
```
При этом пакет установлен, НО у него действительно нет -config.cmake файла в его директории.
```
nikolay@SeaWolf:/opt/ros/melodic/share/message_generation/cmake$ ls
message_generationConfig.cmake  message_generationConfig-version.cmake
```
Схожая проблема есть и у других пользователей cartographer-а(как показало гугление), но решения проблемы, увы, нет.

Nikolaj37, 2020-03-17:
Есть серьёзная проблема, которая ограничивает применимость google_cartographer-а для проекта заварки - это разные версии protobuf-а. Gazebo использует 2.7, а google cartographer 3.4.0. Наличие более старой версии protobuf-а рушит сборку cartographer-а и наоборот. Это оставляет для симуляции только rviz, которого должно быть достаточно, но...

Nikolaj37, 2020-03-17:
Установка google cartographer
```
bash
cd catkin_ws
sudo apt-get update
sudo apt-get install -y python-wstool python-rosdep ninja-build
mkdir cartographer_ws
cd cartographer_ws
wstool init src
wstool merge -t src https://raw.githubusercontent.com/googlecartographer/cartographer_ros/master/cartographer_ros.rosinstall
wstool update -t src
src/cartographer/scripts/install_proto3.sh
rosdep update
rosdep install --from-paths src --ignore-src --rosdistro=${ROS_DISTRO} -y
#Build and install.
catkin_make_isolated --install --use-ninja

прописать в .bashrc
. ~/catkin_ws/cartographer_ws/devel_isolated/setup.bash
```

KaiL4eK, 2020-03-17:
sudo apt install liblua5.3-dev

PonomarevDA, 2020-03-18:
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

Предположу, что отсутствует пакет `defusedxml`.
Если проблема не решилась, попробуй:
```pip2 install defusedxml```
Мне при такой ошибке это помогло.

KaiL4eK, 2020-04-12:
Пока закрываем из-за большого кол-ва проблем и низкого приоритета

Closed 2020-04-12.

Thread 58 (2023-03-04):

Скопировать модели из world_creator и заменить версию sdf

KaiL4eK, 2023-03-04:
Сейчас world_creator на версии noetic по каким-то причинам не собирается. Нужно скопировать модели знаков и светофоров, поменять в них версию sdf и разобраться с причиной отсутствия в симуляторе

PonomarevDA, 2023-03-04:
world creator теперь под noetic собирается: обновил инструкцию по установке, добавил CI на melodic и noetic, а также пофиксил CMakeLists.txt.
Но в gazebo не тестил. Какую версию, кстати, планируете использовать?

KaiL4eK, 2023-03-13:
Привет, спасибо! Используется default из noetic, вроде 11
