lsd-maddrive/zaWRka-project/Altium_projects/zaWRka_Project/zaWRka_Project.pdf

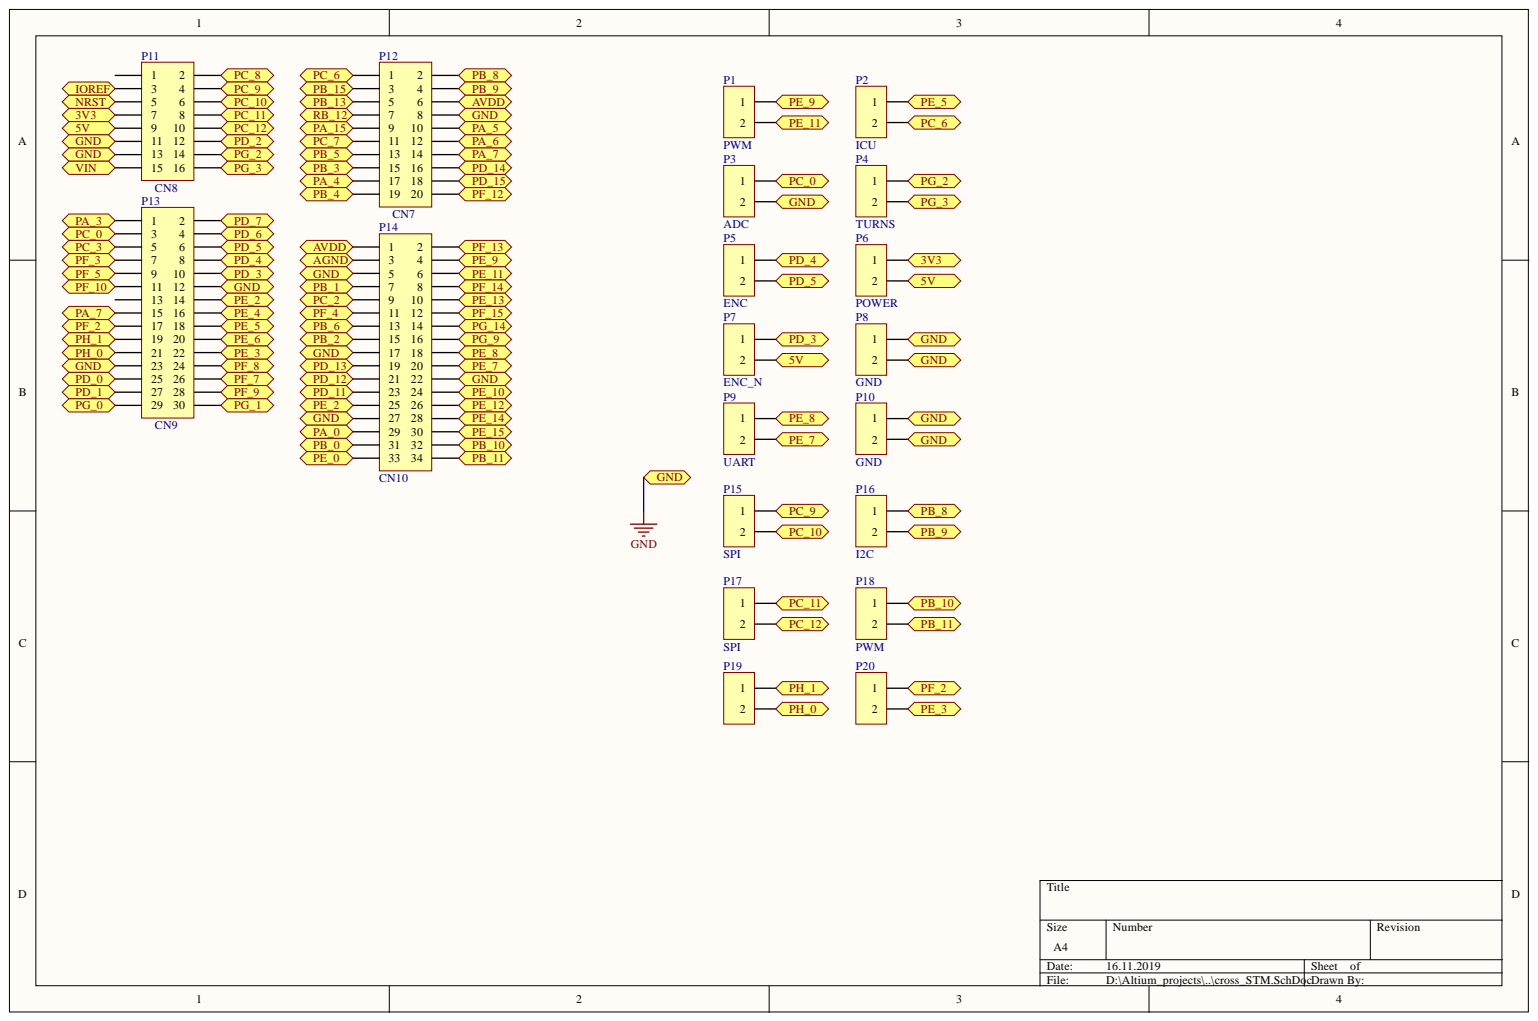
[picture p87: page 1]

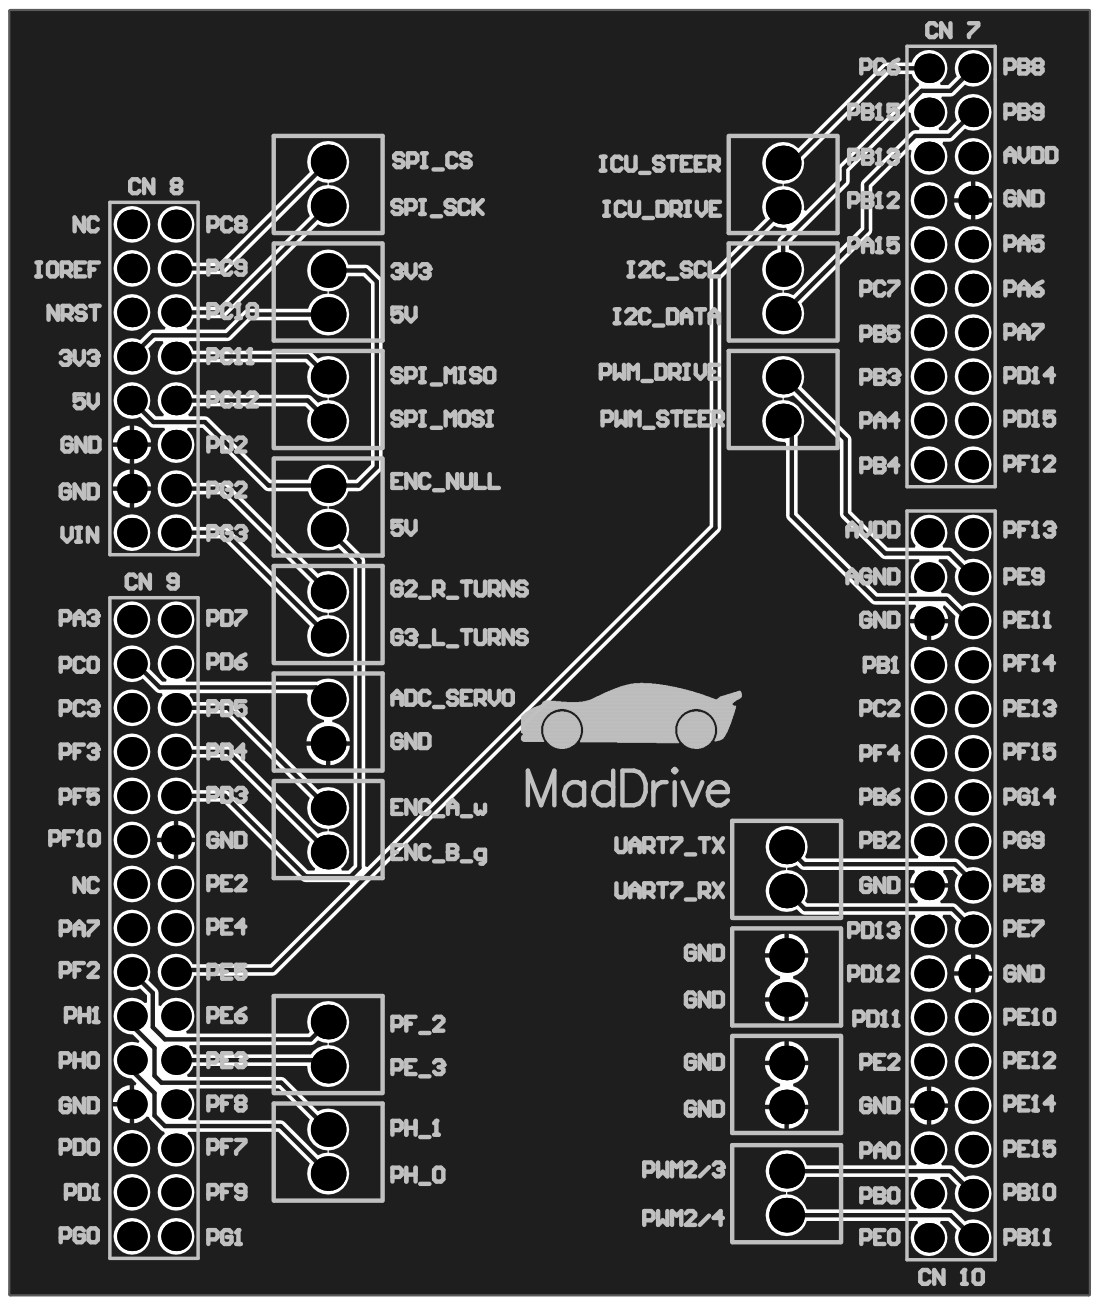
[picture p88: page 2]
