lsd-maddrive/zaWRka-project/(list of files, drawings)

Other design files:
Altium_projects/zaWRka_Project/cross_STM.SchDoc
Altium_projects/zaWRka_Project/cross_stm_PCB.PcbDoc
Altium_projects/zaWRka_Project/zaWRka_Project.PrjPcb
