lsd-maddrive/zaWRka-project/controller_wr_driver/src/debug.c

#include <hal.h>
#include <chprintf.h>

static const SerialConfig sd_st_cfg = {
  .speed = 115200,
  .cr1 = 0, .cr2 = 0, .cr3 = 0
};

static  SerialDriver			*debug_serial = &SD3;
static  BaseSequentialStream    *debug_stream = NULL;

/**
* @brief    Initialization of usb-serial unit
* @note     Stable for repeated calls 
*/
void debug_stream_init( void )
{
    sdStart( debug_serial, &sd_st_cfg );
    palSetPadMode( GPIOD, 8, PAL_MODE_ALTERNATE(7) );
    palSetPadMode( GPIOD, 9, PAL_MODE_ALTERNATE(7) );

    debug_stream = (BaseSequentialStream *)debug_serial;
}

/**
* @brief    Print aka chprintf 
*/
void dbgprintf( const char* format, ... )
{
    if ( !debug_stream )
        return;

    va_list ap;
    va_start(ap, format);
    chvprintf(debug_stream, format, ap);
    va_end(ap);
}
