lsd-maddrive/zaWRka-project/(commit log)

2019-02-11 [encoder] : add speed TPS, RPS
2019-02-12 [odometry]: add funcs - sensless, does not work, I guess
    [common.h, tests.h]
2019-02-12 [ROS] Initial scripts commit
    [RFMaze.sdf, RFMaze.v2.sdf, controllers.yaml, model.urdf.xacro]
2019-02-13 [odometry]: #2 fixed MAYBE, not tested yet
    [common.h]
2019-02-18 [encoder] test new encoder, need to finish module
2019-02-19 [Debug] ++ dbgprintf() func, uses ST-Link serial debug printf
2019-02-19 [odometry]: tests were done with encoder separatelly
2019-02-19 [odometry]: coefficients were fixed
    [lld_odometry.c, test_lld_odometry.c]
2019-02-20 [odometry]: tests done, success
2019-02-20 [odometry]: check test with tickless mode - OK
2019-02-21 [odometry]: reverse for tetta fixed
    [lld_odometry.c]
2019-02-21 [odometry && steer_feedback]: odometry fixed; steer_fb need to be fixed
    [common.h, lld_encoder.c, lld_encoder.h, lld_odometry.c, lld_odometry.h, lld_steering_control.c, lld_steering_control.h, mcuconf.h]
2019-02-21 [pin_usage]: fixed, add steer_fb
2019-02-22 [steer_fb]: some fixes
2019-02-25 [steer_feedback]: mean_filter - done, need more fixes
    [common.h, lld_encoder.h, lld_odometry.c, lld_odometry.h, lld_steer_angle_fb.c, lld_steer_angle_fb.h, test_lld_encoder.c, test_lld_odometry.c]
2019-02-25 [wr8_soft] Odometry fix, working now!
2019-02-25 [odometry]: add Reset-func
2019-02-26 [steering_feedback]: add LPF, tested
2019-02-26 [wr8_soft] Small fixes for odometry reser
2019-02-26 [wr8_soft] Fixed TF system position
    [model.urdf.xacro]
2019-02-26 [steering_feedback]: #6 fixed, Lena should read full text of warning T_T
    [test_lld_steer_angle_fb.c]
2019-02-27 [drive_steer_cs]: add files, there are errors
    [drive_cs.c, drive_cs.h, test_drive_cs.c]
2019-02-28 [steer_cs]: add deadzone, not work
    [common.h, drive_cs.c, drive_cs.h, lld_control.c, lld_control.h, lld_steer_angle_fb.c, test_drive_cs.c, tests.h]
2019-03-01 [wr8_soft] Multiple fixes for graph path integration
    [model.urdf.xacro]
2019-03-01 [steer_cs]: initial coefficient, add new test
2019-03-01 [wr8_soft] Laser scan matcher works
2019-03-01 [steer_cs]: initial done
2019-03-01 [odometry]: bu fixed
2019-03-02 [wr8_firm/ROS] ROS steer changed to degree
2019-03-03 [wr8_soft] monocular calibration
2019-03-03 [wr8_soft] last fixes about visual odometry
2019-03-03 [wr8_soft] SVO visual odometry
2019-03-04 [wr8_soft] Lidar breaks, tested key_teleop
2019-03-04 [speed_cs]: not working - need change speed calculation
    [common.h, drive_cs.c, drive_cs.h, lld_odometry.c, lld_odometry.h, test_drive_cs.c, test_lld_encoder.c]
2019-03-06 [speed_cs]: set controller a little bit, increase pwm freq = 100 Hz
2019-03-07 [lld_tests]: fight with ESC
2019-03-11 [wr8_soft] Lidar great fix! Now have no issues with loading
2019-03-11 [wr8_soft] Small lidar setup fix
2019-03-11 [drive_cs]: #7 fixed use VT instead of GPT
    [common.h, drive_cs.c, mcuconf.h, test_lld_control.c, tests.h]
2019-03-11 [odometry]: use VT instead of GPT2
2019-03-12 [ext]: add common ext, test with button - done
2019-03-12 [wr8_soft] Rendering LaserScan over rviz requires setting fixed frame as laser_frame
2019-03-12 [wr8_soft] Lidar setup for current construction
2019-03-13 [wr8_soft] Lidar geometry update
2019-03-13 [wr8_soft] First prototype of NCS inference with ROS
2019-03-13 [drive_cs]: forward sets, need fix in 0 and back
    [common.h, drive_cs.c, remote_control.c, test_drive_cs.c, test_lld_control.c, test_remote_control.c, tests.h]
2019-03-14 [controller_driver] Added system timer test
2019-03-15 [speed_cs]: add active brake for forward moving
2019-03-15 [wr8_soft] Small fixes about melodic ROS
    [model.urdf.xacro]
2019-03-16 [steer_fb]: filter lpf fixed
    [common.h, lld_control.c, lld_steer_angle_fb.c, lld_steer_angle_fb.h, test_lld_control.c, test_lld_steer_angle_fb.c]
2019-03-16 [wr8_firmware] ++ odometry correction rates
    [lld_odometry.c, lld_odometry.h, main_control_unit.c]
2019-03-16 [odometry]: set correction coefficients
    [common.h, drive_cs.c, drive_cs.h, lld_control.c, lld_odometry.c, lld_start_button.c, main_control_unit.c]
2019-03-16 [common]: fix some warnings
    [common.h, lld_control.c, lld_encoder.h, lld_odometry.c, lld_start_button.c, main_control_unit.c, remote_control.c, test_drive_cs.c]
2019-03-17 [wr8_soft] Small fix on Melodic ROS
    [model.urdf.xacro]
2019-03-20 [main]: add led3 for RUN to main
2019-03-20 [light] SPI doesn't work T_T
    [common.h, lld_light.c, test_lld_light.c]
2019-03-21 [main]: change threads -> 256, remove too often commnets
2019-03-22 [wr8_ros] Current fixes, state after second day
2019-04-01 [steer_drive]: fix limits, new servo
    [common.h, lld_control.c, lld_steer_angle_fb.c, test_lld_control.c, test_lld_steer_angle_fb.c]
2019-04-05 [drive_cs]: fix PID for steering
    [common.h, drive_cs.c, test_drive_cs.c]
2019-04-05 [remote control]: fix limits
    [common.h, remote_control.c, test_remote_control.c]
2019-04-13 [ros] small fixes for debug
    [main_control_unit.c]
2019-05-13 [remote_control]: set new limits for new servo
2019-05-13 [cs_tests]: add uart_cs_test need tests
2019-05-13 [cs_tests]: tests for UART control - done
2019-05-22 [remote_control]add RC-test with odometry
2019-05-22 [remote] add test with odometry spamming
2019-05-22 [remote] saturation for speed in test, only for uart
2019-05-31 [rc-tests]: add new test to test odometry with RC, add some comments, clean some warnings
2019-09-13 [controller_wr_driver]: add odometry tests
2019-09-16 [tests]: System Timer test is removed
2019-09-18 Added lidar submodule, some info in readme
2019-09-18 MASTER ROUTINE LED1 Toggle was removed
2019-09-22 [ROS] fixed collisions with base_* frames - only base_link left
    [controllers.yaml, model.urdf.xacro]
2019-10-05 small fixes in drive_cs
    [drive_cs.c, test_drive_cs.c, test_lld_control.c]
2019-10-08 [ROS] wr8_description fixed TF collision in model, wip fixing model rendering
    [model.urdf.xacro]
2019-10-09 [ROS/gazebo] New model representation
    [controllers.yaml, model.urdf.xacro]
2019-10-09 [ROS/gazebo] Steering angle done
    [model.urdf.xacro]
2019-10-09 [ROS/gazebo] Odom publish done
    [model.urdf.xacro]
2019-10-09 [ROS/gazebo] Old files removed
    [controllers.yaml]
2019-10-13 [ROS] Cleaned wr8_software (removed many old files) / simple tested RTABmap with stereo camera
2019-10-23 [world creator] add prototype
2019-10-24 [uC] lower limits of steer control / use name for remote load
2019-10-25 [world creator] add simple sign with bad texture
    [stop_sign.sdf]
2019-10-26 [uC] Tuned servo parameters
2019-10-26 [world creator ] add signs to backend
    [stop_sign.sdf]
2019-11-07 [ROS] added sign SDF with mesh
    [model.sdf, stop_sign.sdf]
2019-11-09 [ROS/ADC calib] ADC calibration test proto
2019-11-09 add ros raw adc processing
2019-11-09 ros raw adc
2019-11-11 [uC/steer_calib] Some refactoring in code
2019-11-11 [uC/steer_calib] Removed ackermann-controller
2019-11-11 [uC/steer_calib] Removed bad debug printf
2019-11-11 [uC/steer_calib] Fixed bug in lld_control
    [lld_control.c]
2019-11-12 [ROS] signs models created
    [model.sdf]
2019-11-14 [uc] Remote control tested / RC steer channel has issues
    [common.h, remote_control.c]
2019-11-14 [ROS/world_creator] First step
    [box.sdf, model.sdf]
2019-11-16 [world_creator] Added lost file / fixed bug with multiple buttons pressed
2019-11-18 [ROS/world_creator] TL model folder added, set boxes static
    [box.sdf]
2019-11-19 [ROS/world_creator] improve traffic light sdf model
    [model.sdf]
2019-11-25 [common] Added reading data -> full ROS connection prototype
2019-11-26 [new_proto] Some fixes, failed link control test
    [common.h]
2019-11-27 [ROS] Serial boost issue solved
    [uc_ros_link.cpp]
2019-12-04 [controller] PR #29 Fixes (comments)
    [link_def.h]
2019-12-04 [controller] More info on tests / PR #29 fixes
    [tests.h]
2019-12-26 [ROS] Signs camera WIP
2019-12-29 [ROS global planner] add default global planner pkg
    [GlobalPlanner.cfg]
2020-01-09 [ROS global planner] rename and little fix in wr8_software launch files
    [GlobalPlanner.cfg]
2020-01-10 [ROS global planner] optimisation and code style fixes
    [planner_core.cpp]
2020-01-10 [ROS global planner] add fragmentation and fix point removal bug
    [planner_core.cpp]
2020-01-11 add folders: 3D models and Altium project
    [Battery_holder.FCStd, Battery_holder.stl, Battery_up_1.stl, Button_holder_2.stl, Button_holder_v2.FCStd, ESC_holder_tight.FCStd, ESC_holder_tight.stl, Motor_hold.FCStd]
2020-01-12 [ROS global planner] add params and fix bug in fragmentation
    [planner_core.cpp]
2020-01-12 Stereo camera + signs camera not tested
    [model.urdf.xacro]
2020-01-12 Steome fixes
    [model.urdf.xacro]
2020-01-13 Stereo camera with processing done
    [model.urdf.xacro]
2020-01-13 Signs camera prepared - test required
    [model.urdf.xacro]
2020-01-15 Added pointcloud to laser convertion
2020-01-25 Simplified steer CS - cleaning required
2020-01-27 [ROS/traffic_light_plugin] add simple blinking red-green
    [model.sdf]
2020-01-27 [ROS/traffic_light_plugin] add subscriber
    [model.sdf]
2020-01-29 [ROS/new_gz_objects] Added white line + fixed TLs
    [line.sdf, model.sdf]
2020-01-31 [ROS/new_gz_objects] style fixes
    [model.sdf]
2020-02-01 Refactoring + stereo frames and scripts fixed
    [model.urdf.xacro]
2020-02-01 [ROS global planner] Pull request #34 fixes: rename variable and delete redundant condition
    [planner_core.cpp]
2020-02-02 [ROS common] add stereo switcher
    [model.urdf.xacro]
2020-02-15 [ROS stereo frequency converter] add node for simulator
    [model.urdf.xacro]
2020-02-17 [ROS stereo frequency converter] review #37 fixes
    [model.urdf.xacro]
2020-02-22 [ROS main solver] add main_solver capable of solving first 2 stages without white lines and signs
2020-03-03 Small fixes + testing
    [link_def.c]
2020-03-03 Added ydlidar device rules to install_pkgs.sh
2020-03-03 [ROS main solver] add timer before start
2020-03-07 Fixed gazebo stereo flag, added rules installation
    [model.urdf.xacro]
2020-03-07 [3D_models]: add new 3d models (box for power converter)
    [STM_holder_rev.FCStd, STM_holder_rev.stl, box_power.FCStd, box_power.stl, frame.FCStd, wr8_frame.stl]
2022-01-01 Bump lxml from 4.6.3 to 4.6.5 in /world_creator (#56)
    * Bump lxml from 4.6.3 to 4.6.5 in /world_creator
    Bumps [lxml](https://github.com/lxml/lxml) from 4.6.3 to 4.6.5.
    - [Release notes](https://github.com/lxml/lxml/releases)
    - [Changelog](https://github.com/lxml/lxml/blob/master/CHANGES.txt)
    - [Commits](https://github.com/lxml/lxml/compare/lxml-4.6.3...lxml-4.6.5)
    ---
    updated-dependencies:
    - dependency-name: lxml
    dependency-type: direct:production
    ...
    * make world_creator as disctinct repo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
    [box.sdf, line.sdf, model.sdf]
2022-02-20 WIP moving code from Autonet2020
    [WPGlobalPlanner.cfg]
